midhunjac/RF-handover/Graphs/Data_collected/Data_collected/Supplementary/BodyPos_schematic.PNG

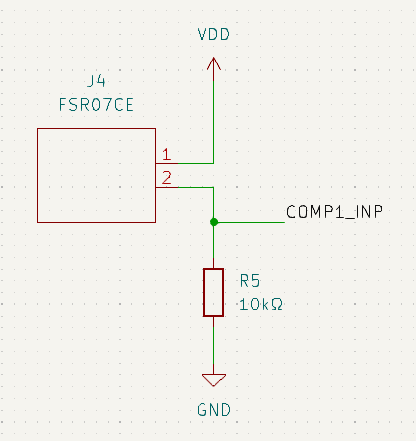
Graphs/Data_collected/Data_collected/Supplementary/BodyPos_schematic.PNG
