midhunjac/RF-handover/Graphs/Data_collected/Data_collected/Supplementary/Cadence_schematic.PNG

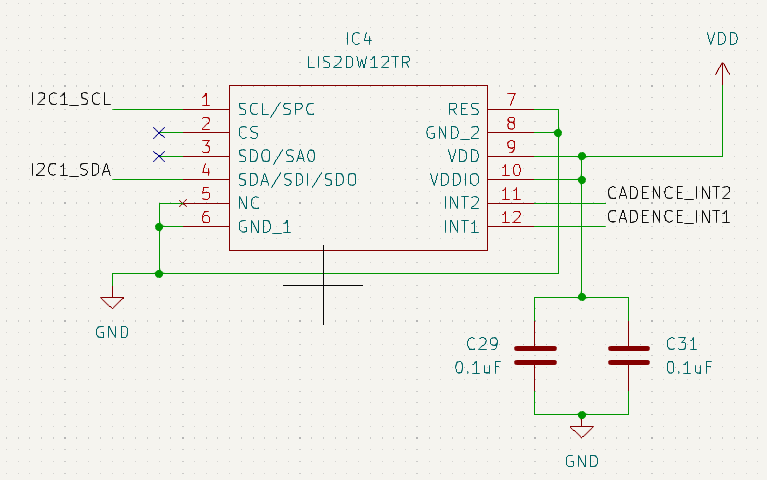
Graphs/Data_collected/Data_collected/Supplementary/Cadence_schematic.PNG
