midhunjac/RF-handover/Graphs/Data_collected/Data_collected/Supplementary/HandPos_schematic.PNG

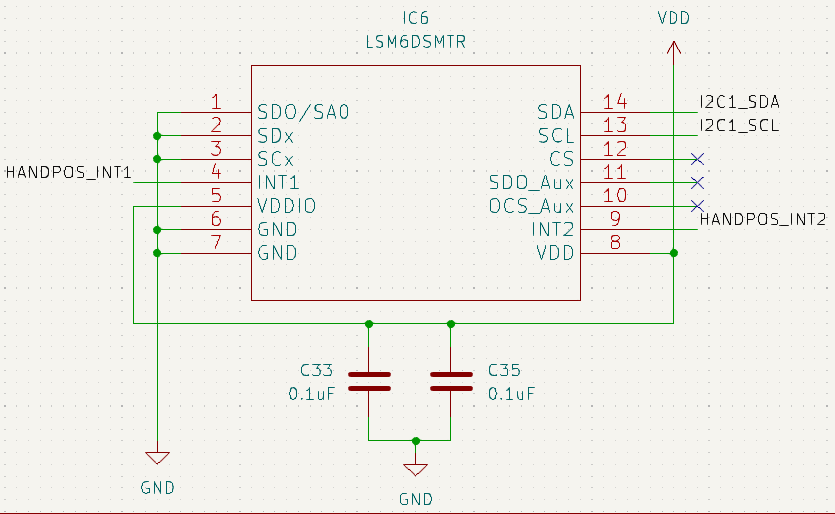
Graphs/Data_collected/Data_collected/Supplementary/HandPos_schematic.PNG
