midhunjac/RF-handover/Graphs/Data_collected/Data_collected/Supplementary/Temperature_schematic.PNG

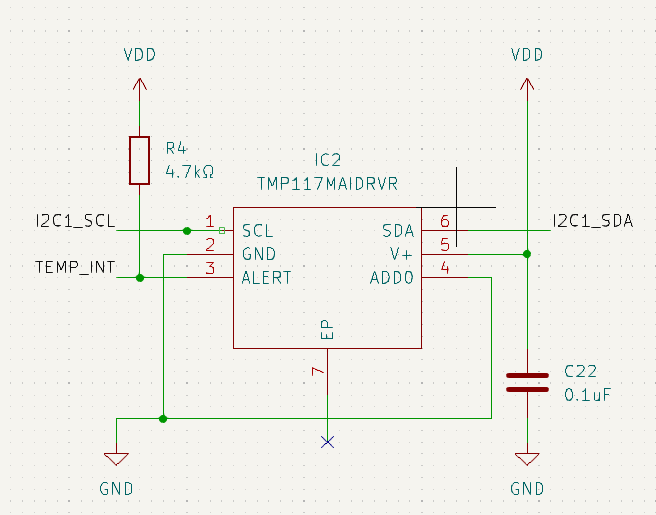
Graphs/Data_collected/Data_collected/Supplementary/Temperature_schematic.PNG
