midhunjac/RF-handover/Flexible Temperature Sensor/KiCAD/BOM.xlsx

Comment | Designator | Footprint | JLCPCB Part
MCU | IC5 | UFQFPN-48(7x7) | C3606695
10k resistor | R1 | 0603 | C1511834
Tactile switch | S1 | SMD, 2.8x4.6mm | C99271
Schottky Diode | D1 | SOD-523 | C283259
0.1uF Ceramic Capacitor | C3, C4, C5, C6, C7, C8, C9, C10, C12, C14, C18, C40 | 0603 | C14663
10pF Ceramic Capacitor | C1, C2 | 0603 | C85966
4.7k resistor | R2, R3, R4, R5, R6, R7 | 0603 | C723699
0.1nF Ceramic Capacitor | C16 | 0603 | C3885945
4.7uF Ceramic Capacitor | C21 | 0603 | C458917
10nH Inductor | L1 | 0603 | C86131
470uF Electrolytic Capacitor | C11 | SMD,D8xL10.2mm | C401707
2.5V voltage Detector | U1 | SOT-23-3 | C216610
N Channel MOSFET | Q2, Q3 | SOT-23(TO-236) | C142553
P Channel MOSFET | Q1 | SOT-23 | C168745
2.0V Voltage Detector | U2 | SOT-23 | C2461421
Temperature Sensor | IC1, IC2, IC3, IC4 | WDFN-6-EP(2x2) | C699536
560k Resistor | R8 | 0603 | C441907
