midhunjac/RF-handover/Flexible Temperature Sensor/KiCAD/BOM_components.xlsx

Sheet: JLCPCB
MFR Part | JLCPCB Part | Package | Designator | Description
STM32WB15CCU6 | C3606695 | UFQFPN-48(7x7) | IC5 | MCU
CRCW060310K0JNEBC | C1511834 | 0603 | R1 | 10k resistor
KMR231GLFS | C99271 | SMD, 2.8x4.6mm | S1 | Tactile switch
BAT54KFILM | C283259 | SOD-523 | D1 | Schottky Diode
CC0603KRX7R9BB104 | C14663 | 0603 | C3, C4, C5, C6, C7, C8, C9, C10, C12, C14, C18, C40 | 0.1uF Ceramic Capacitor
0603N100K500CT | C296045 | 0603 | C1, C2 | 10pF Ceramic Capacitor
RT0603DRE074K7L | C723699 | 0603 | R2, R3, R4, R5, R6, R7 | 4.7k resistor
GRM1885C1H101GA01J | C3885945 | 0603 | C16 | 0.1nF Ceramic Capacitor
0603X475M100CT | C458917 | 0603 | C21 | 4.7uF Ceramic Capacitor
LQW18AN10NG00D | C86131 | 0603 | L1 | 10nH Inductor
EEEFK1C471AP | C401707 | SMD,D8xL10.2mm | C11 | 470uF Electrolytic Capacitor
XC61CC2502MR-G | C216610 | SOT-23-3 | U1 | 2.5V voltage Detector
SI2342DS-T1-GE3 | C142553 | SOT-23(TO-236) | Q2, Q3 | N Channel MOSFET
NTR2101PT1G | C168745 | SOT-23 | Q1 | P Channel MOSFET
XC61CC2002MR-G | C2461421 | SOT-23 | U2 | 2.0V Voltage Detector
TMP117AIDRVR | C699536 | WDFN-6-EP(2x2) | IC1, IC2, IC3, IC4 | Temperature Sensor
ERJPA3J564V | C441907 | 0603 | R8 | 560k Resistor

Sheet: Digikey
Mfr No | Digikey No | Designator | Comment
M20-8760342 | 952-1922-ND | J3 | 2x6 Pin Header, 2.54mm
NX2016SA-32MHZ-EXS00A-CS06654 | 644-1373-1-ND | Y1 | Crystal 32MHz
NX2012SA-32.768KHZ-EXS00A-MU00389 | 644-1350-1-ND | Y2 | Crystal 32.768kHz
HZ0603C601R-10 | 240-2380-1-ND | FB1 | Ferrite Bead 600Ohm
74479777310A | 732-74479777310ACT-ND | L2 | 10uH Inductor
M20-8770242 | M20-8770242-ND | J2 | 1x2 Pin Header, 2.54mm
