midhunjac/RF-handover/Flexible Temperature Sensor/KiCAD/gdp_flexible.kicad_pcb

## KiCad design Flexible Temperature Sensor/KiCAD/gdp_flexible.kicad_pcb (2024-02-27)

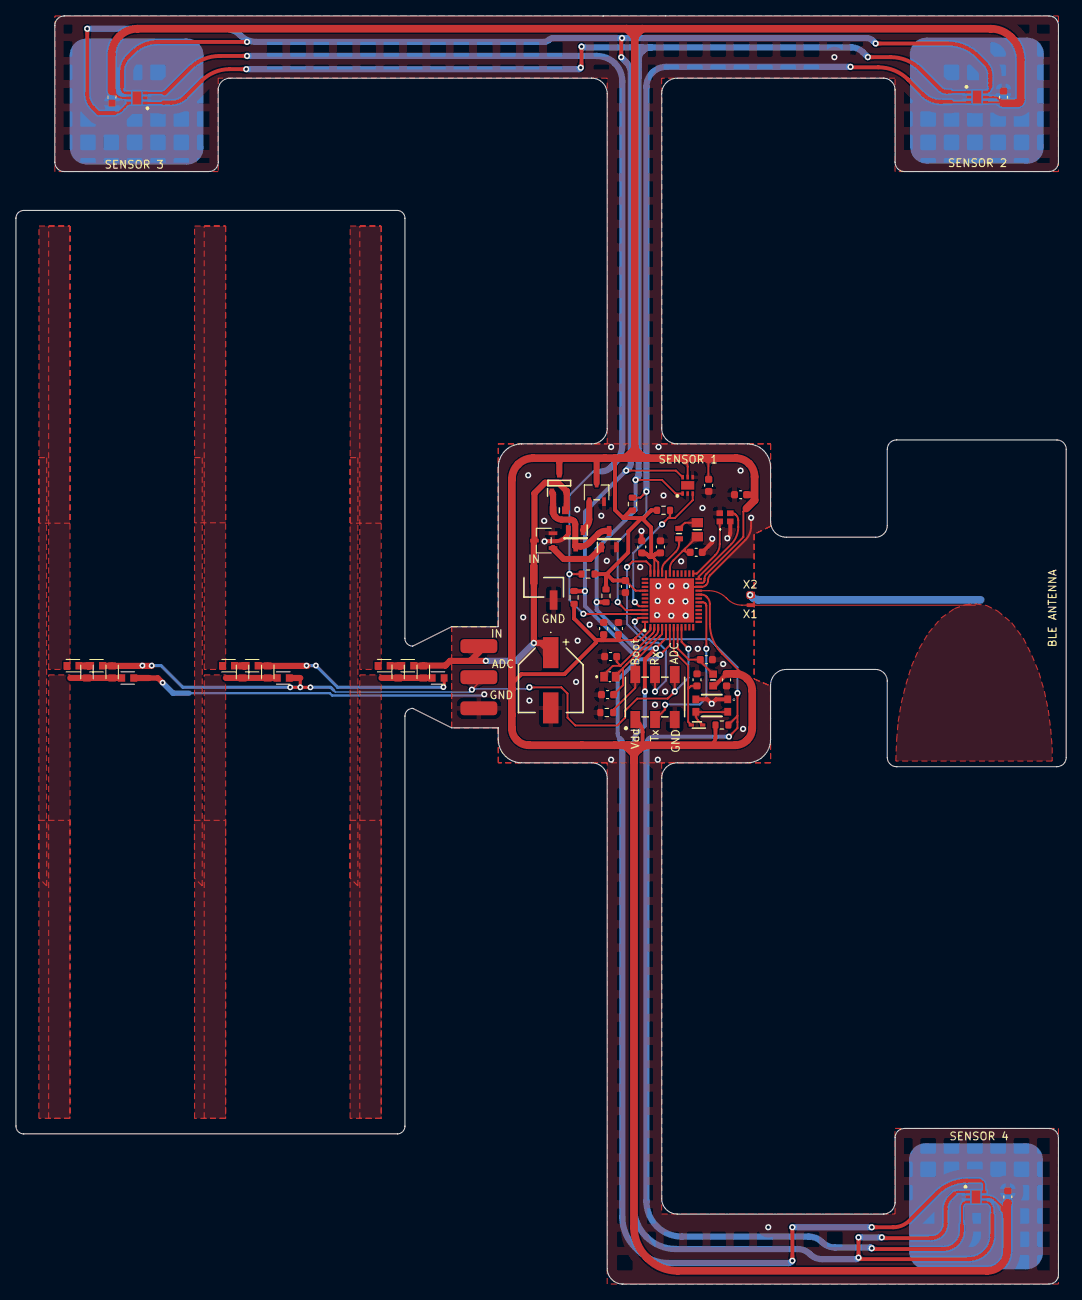
[picture p13: board gdp_flexible.kicad_pcb from above]

Board: 2 copper layers, 135.0 x 163.0 mm, 61 parts (0 on the bottom side), 27 nets.

Parts:
C1, C2: 10pF; C_0603_1608Metric
C3, C4, C5, C6, C7, C8, C9, C10, C12, C14, C18, C40: 0.1uF; C_0603_1608Metric
C11: EEE-FK1C471AP; EEHZT1E331UP
C16: 0.1nF; C_0603_1608Metric
C21: 4.7uF; C_0603_1608Metric
C50, C51, C52, C53, C54, C55, C56, C57, C58, C59, C60, C61: CAPC1608X85
D1: BAT54KFILM; SODFL1608X70N
FB1: HZ0603C601R-10; BEADC1608X95N
IC1, IC2, IC3, IC4: TMP117AIDRVR; SON65P200X200X80-7N
IC5: STM32WB15CCU6; QFN50P700X700X60-49N-D
J2: M20-8770242
J3: M20-8760342
L1: LQW18AN10NG00D; LQW18AS10NG0CD
L2: 74479777310A; INDC2112X140N
L3, L4, L5: INDC1608X95N
Q1: NTR2101PT1G; SOT96P237X111-3N
Q2, Q3: SI2342DS-T1-GE3; SOT95P237X102-3N
R1: 10kΩ; R_0603_1608Metric
R2, R3, R4, R5, R6, R7: 4.7kΩ; R_0603_1608Metric
R8: RESC1608X55N
S1: KMR231GLFS; KMR2_1
U1: XC61CC2502MR-G; XC61C_SOT-23_TOR
U2: XC61CC2002MR-G; XC61C_SOT-23_TOR
X1: Antenna_Flexible_RF
X2: Antenna_Flexible_GND
Y1: NX2016SA-32MHZ-EXS00A-CS06654; NX2016SA32MHZEXS00ACS06654
Y2: NX2012SA-32.768KHZ-EXS00A-MU00389; NX2012SA32768KHZEXS00AMU00530

Connections:
/NRST: C3.1, D1.2, IC5.7 (NRST)
/PH3-BOOT0: IC5.4 (PH3-BOOT0), J3.2, R1.2
/RCC_OSC32_IN: C1.1, IC5.2 (PC14-OSC32_IN), Y2.1
/RCC_OSC32_OUT: C2.1, IC5.3 (PC15-OSC32_OUT), Y2.2
/RCC_OSC_IN: IC5.25 (OSC_IN), Y1.1 (CRYSTAL_1)
/RCC_OSC_OUT: IC5.24 (OSC_OUT), Y1.3 (CRYSTAL_2)
/RF1: IC5.21 (RF1), X1.1 (RF)
/USART1_RX: IC5.36 (PA10), J3.4
/USART1_TX: IC5.18 (PA9), J3.3
/VDDA: C4.1, FB1.2, IC5.8 (VDDA)
/VFBSMPS: C21.1, IC5.31 (VFBSMPS), L2.2
/VLXSMPS: IC5.33 (VLXSMPS), L1.1
ADC: C58.1, C59.1, IC5.9 (PA0), J3.6, L4.1
GND: C1.2, C2.2, C3.2, C4.2, C5.2, C6.2, C7.2, C8.2, C9.2, C10.2, C11.2 (-), C12.2, C14.2, C16.2, C18.2, C21.2, C40.2, IC1.2 (GND_1), IC1.4 (ADD0), IC2.2 (GND_1), IC3.2 (GND_1), IC4.2 (GND_1), IC5.22 (VSSRF), IC5.32 (VSSSMPS), IC5.49 (EP), J2.2, J3.5, L5.1, Q2.2 (S), Q3.2 (S), R1.1, S1.1, S1.2, U1.2 (VSS), U2.2 (VSS), X2.1 (GND), Y1.2 (GND_1), Y1.4 (GND_2)
I2C_SCL: IC1.1 (SCL), IC2.1 (SCL), IC3.1 (SCL), IC4.1 (SCL), IC4.4 (ADD0), IC5.5 (PB8), R3.2
I2C_SDA: IC1.6 (SDA), IC2.6 (SDA), IC3.4 (ADD0), IC3.6 (SDA), IC4.6 (SDA), IC5.6 (PB9), R2.2
unnamed: C11.1 (+), C50.1, C51.1, J2.1, Q1.2 (S), R8.2, U1.3 (VIN)
unnamed: D1.1, S1.3, S1.4
unnamed: L1.2, L2.1
unnamed: Q1.1 (G), Q2.3 (D), Q3.3 (D), R8.1
unnamed: Q2.1 (G), U1.1 (VOUT)
unnamed: Q3.1 (G), U2.1 (VOUT)
TEMP_INT_1: IC1.3 (ALERT), IC5.44 (PB4), R4.2
TEMP_INT_2: IC2.3 (ALERT), IC5.45 (PB5), R6.2
TEMP_INT_3: IC3.3 (ALERT), IC5.46 (PB6), R5.2
TEMP_INT_4: IC4.3 (ALERT), IC5.47 (PB7), R7.2
VDD_OUTPUT: C5.1, C6.1, C7.1, C8.1, C9.1, C10.1, C12.1, C14.1, C16.1, C18.1, C40.1, FB1.1, IC1.5 (V+), IC2.4 (ADD0), IC2.5 (V+), IC3.5 (V+), IC4.5 (V+), IC5.1 (VBAT), IC5.20 (VDD_1), IC5.23 (VDDRF), IC5.34 (VDDSMPS), IC5.35 (VDD_2), IC5.40 (VDD_3), IC5.48 (VDD_4), J3.1, Q1.3 (D), R2.1, R3.1, R4.1, R5.1, R6.1, R7.1, U2.3 (VIN)
