midhunjac/RF-handover/Flexible Temperature Sensor/KiCAD/gdp_flexible_d3.kicad_pcb

## KiCad design Flexible Temperature Sensor/KiCAD/gdp_flexible_d3.kicad_pcb (2024-02-27)

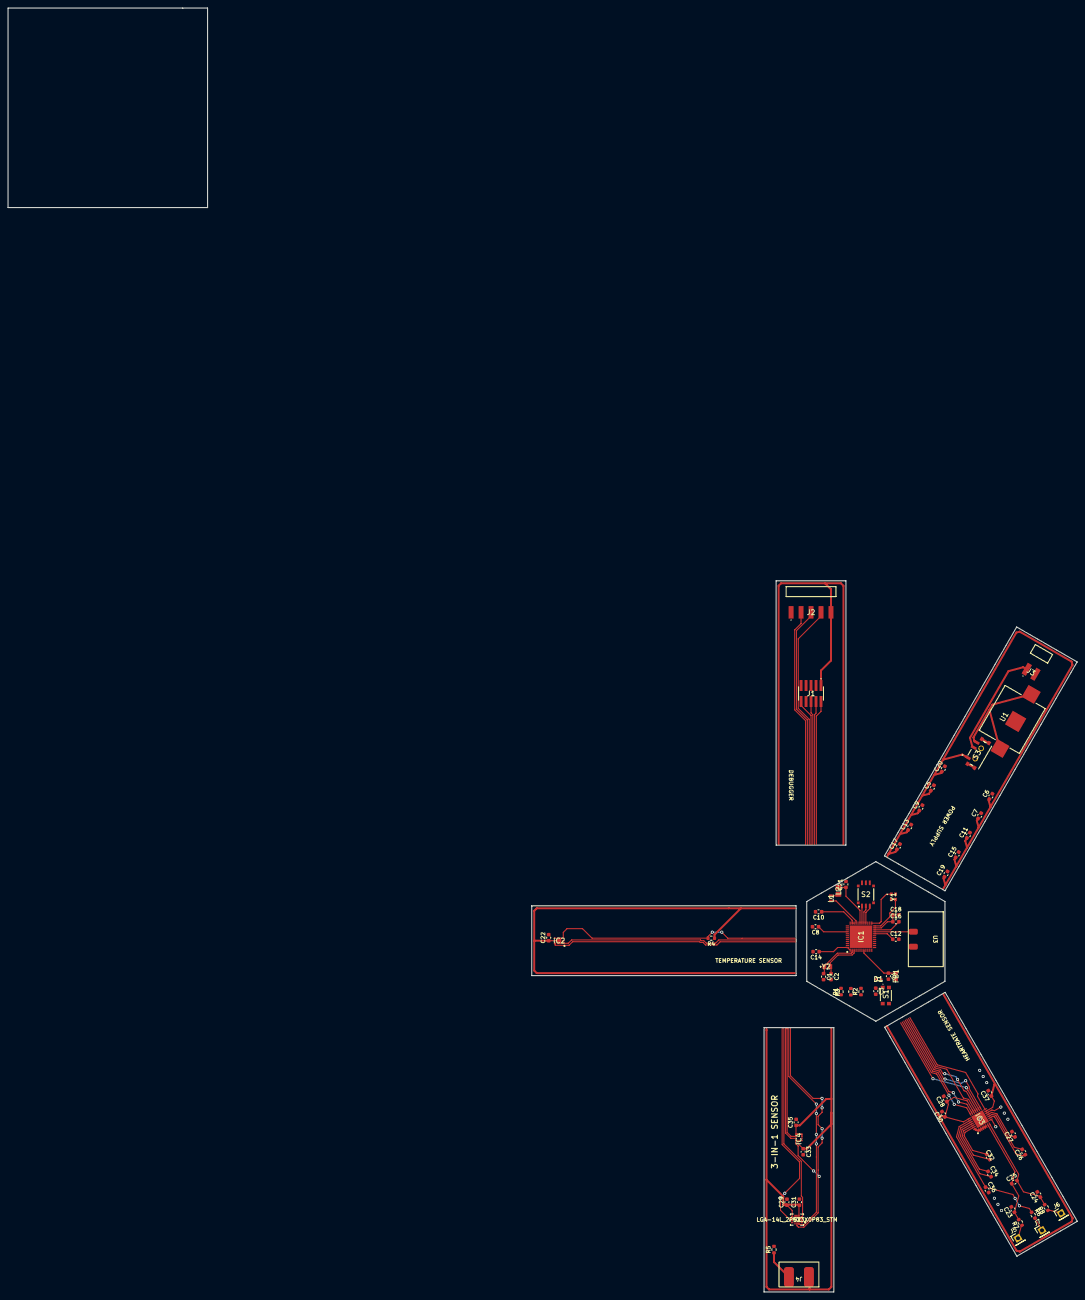
[picture p14: board gdp_flexible_d3.kicad_pcb from above]

Board: 2 copper layers, 272.3 x 326.9 mm, 68 parts (0 on the bottom side), 50 nets.

Parts:
C1, C2, C3, C4, C5, C6, C7, C8, C9, C10, C11, C12, C13, C14, C15, C16, C17, C18, C19, C20, C21, C22, C23, C24, C25, C26, C27, C28, C29, C30, C31, C32, C33, C34, C35, C36, C37: C; C_0603_1608Metric
D1: BAT54KFILM; SODFL1608X70N
FB1: HZ0603C601R-10; BEADC1608X95N
IC1: STM32WB15CCU6; QFN50P700X700X60-49N-D
IC2: TMP117MAIDRVR; SON65P200X200X80-7N
IC3: MAX30003CTI+; QFN50P500X500X80-29N
IC4: LIS2DW12TR; LGA-12
J1: FTS-105-01-F-DV-TR; FTS-105-YY-XX-DV-TR
J2: TSM-105-01-T-SH; TSM-105-YY-ZZZ-SH
J3: TSM-102-01-L-SH; TSM-102-YY-ZZZ-SH
J4: FSR07CE
J5, J6, J7: Conn_01x01; PinHeader_1x01_P2.54mm_Vertical
L1: LQW18AN10NG00D; LQW18AS10NG0CD
L2: 74479777310A; INDC2112X140N
R1, R2, R3, R4, R5, R6, R7, R8: R; R_0603_1608Metric
S1: KMR231GLFS; KMR2_1
S2: CVS-03TB; CVS03TB
S3: CUS-12TB; CUS-12B
U1: S8201-46R
U2: LGA-14L_2P5X3X0P83_STM; LSM6DSMTR
U3: Antenna_Flexible_BLE
Y1: NX2016SA-32MHZ-EXS00A-CS06654; NX2016SA32MHZEXS00ACS06654
Y2: NX2012SA-32.768KHZ-EXS00A-MU00389; NX2012SA32768KHZEXS00AMU00530

Connections:
/CADENCE_INT1: IC1.47 (PB7), IC4.11 (INT2)
/CADENCE_INT2: IC1.46 (PB6), IC4.12 (INT1)
/CAPN: C26.2, IC3.10 (CAPN)
/CAPP: C26.1, IC3.9 (CAPP)
/COMP1_INP: IC1.19 (PB2), J4.2, R5.1
/CPPL: C27.1, IC3.11 (CPLL)
/ECGN: C24.1, C25.2, IC3.7 (ECGN), R8.2
/ECG_P: C23.1, C25.1, IC3.6 (ECGP), R7.2
/HANDPOS_INT1: IC1.45 (PB5), U2.4 (INT1)
/HANDPOS_INT2: IC1.44 (PB4), U2.9 (INT2)
/HR_INT1: IC1.11 (PA2), IC3.21 (INTB)
/HR_INT2: IC1.12 (PA3), IC3.20 (INT2B)
/I2C1_SCL: IC1.5 (PB8), IC2.1 (SCL), IC4.1 (SCL/SPC), R3.2, U2.13 (SCL)
/I2C1_SDA: IC1.6 (PB9), IC2.6 (SDA), IC4.4 (SDA/SDI/SDO), R2.2, U2.14 (SDA)
/MODE_B1: IC1.30 (PE4), S2.A1 (COM_1)
/MODE_B2: IC1.29 (PB1), S2.A2 (COM_2)
/MODE_B3: IC1.28 (PB0), S2.A3 (COM_3)
/NRST: D1.1, J1.10, S1.1, S1.3
/OSC_IN: IC1.25 (OSC_IN), Y1.1 (CRYSTAL_1)
/OSC_OUT: IC1.24 (OSC_OUT), Y1.3 (CRYSTAL_2)
/PB11-NRST: C3.1, D1.2, IC1.7 (NRST)
/PC14-OSC32_IN: C1.1, IC1.2 (PC14-OSC32_IN), Y2.1
/PC15-OSC32_OUT: C2.1, IC1.3 (PC15-OSC32_OUT), Y2.2
/PH3-BOOT0: IC1.4 (PH3-BOOT0), J2.4, R1.2
/RCC_MCO: IC1.17 (PA8), IC3.14 (FCLK)
/RF1: IC1.21 (RF1), U3.1
/SPI1_MISO: IC1.15 (PA6), IC3.18 (SDO)
/SPI1_MOSI: IC1.14 (PA5), IC3.17 (SDI)
/SPI1_NSS: IC1.13 (PA4), IC3.15 (CSB)
/SPI1_SCK: IC1.10 (PA1), IC3.16 (SCLK)
/SYS_JTCK-SWCLK: IC1.41 (PA14), J1.4
/SYS_JTDO-SWO: IC1.43 (PB3), J1.6
/SYS_JTMS-SWDIO: IC1.39 (PA13), J1.2
/TEMP_INT: IC1.42 (PA15), IC2.3 (ALERT), R4.2
/USART1_RX: IC1.36 (PA10), J2.3
/USART1_TX: IC1.18 (PA9), J2.2
/VBG: C32.1, IC3.27 (VBG)
/VCM: C34.1, IC3.25 (VCM)
/VDAA: C4.1, FB1.2, IC1.8 (VDDA)
/VDD_BAT: S3.3, U1.1, U1.3
/VDD_PS: J3.1, S3.2
/VFBSMPS: C21.1, IC1.31 (VFBSMPS), L2.2
/VLXSMPS: IC1.33 (VLXSMPS), L1.1
/VREF: C36.1, IC3.23 (VREF), R6.1
GND: C1.2, C2.2, C3.2, C4.2, C5.2, C6.2, C7.2, C8.2, C9.2, C10.2, C11.2, C12.2, C13.2, C14.2, C15.2, C16.2, C17.2, C18.2, C19.2, C20.2, C21.2, C22.2, C23.2, C24.2, C27.2, C28.2, C29.2, C30.2, C31.2, C32.2, C33.2, C34.2, C35.2, C36.2, C37.2, IC1.22 (VSSRF), IC1.32 (VSSSMPS), IC1.49 (EP), IC2.2 (GND), IC2.4 (ADD0), IC3.1 (I.C._1), IC3.2 (I.C._2), IC3.3 (AGND_1), IC3.4 (I.C._3), IC3.5 (I.C._4), IC3.8 (AGND_2), IC3.12 (DGND), IC3.24 (I.C._5), IC3.26 (I.C._6), IC3.28 (AGND_3), IC3.29 (THERMAL_PAD), IC4.6 (GND_1), IC4.7 (RES), IC4.8 (GND_2), J1.3, J1.5, J2.1, J3.2, R1.1, R5.2, S1.2, S1.4, S2.MP1, S2.MP2, S2.MP3, S2.MP4, S3.4, S3.5, S3.6, S3.7, U1.2, U2.1 (SDO/SA0), U2.2 (SDx), U2.3 (SCx), U2.6 (GND), U2.7 (GND), U3.2, Y1.2 (GND_1), Y1.4 (GND_2)
unnamed: J5.1, R7.1
unnamed: J6.1, R8.1
unnamed: J7.1, R6.2
unnamed: L1.2, L2.1
VDD: C5.1, C6.1, C7.1, C8.1, C9.1, C10.1, C11.1, C12.1, C13.1, C14.1, C15.1, C16.1, C17.1, C18.1, C19.1, C20.1, C22.1, C28.1, C29.1, C30.1, C31.1, C33.1, C35.1, C37.1, FB1.1, IC1.1 (VBAT), IC1.20 (VDD_1), IC1.23 (VDDRF), IC1.34 (VDDSMPS), IC1.35 (VDD_2), IC1.40 (VDD_3), IC1.48 (VDD_4), IC2.5 (V+), IC3.13 (DVDD), IC3.19 (OVDD), IC3.22 (AVDD), IC4.2 (CS), IC4.9 (VDD), IC4.10 (VDDIO), J1.1, J2.5, J4.1, R2.1, R3.1, R4.1, S2.B1 (NO_1), S2.B2 (NO_2), S2.B3 (NO_3), S3.1, U2.5 (VDDIO), U2.8 (VDD)
