midhunjac/RF-handover/Flexible Temperature Sensor/Rectenna_final/PCB_rectenna_withL_Array v2.kicad_pcb

## KiCad design Flexible Temperature Sensor/Rectenna_final/PCB_rectenna_withL_Array v2.kicad_pcb (2024-02-27)

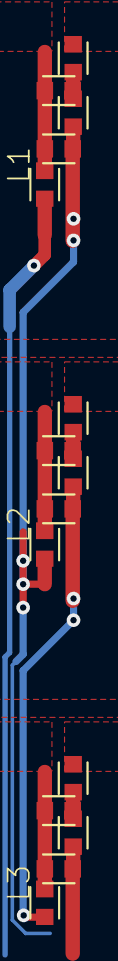
[picture p15: board PCB_rectenna_withL_Array v2.kicad_pcb from above]

Board: 2 copper layers, 15 parts (0 on the bottom side), 9 nets.

Parts:
C1, C2, C3, C4, C5, C6, C7, C8, C9, C10, C11, C12: CAPC1608X85
L1, L2, L3: INDC1608X95N

Connections:
ADC: C6.1, C7.1, L2.1
ANTIN: C4.1, C5.1, C7.2, L1.2
ANTIN2: C1.1, C2.1, C8.2, L2.2
ANTIN4: C9.1, C10.1, C12.2, L3.2
INPUT1: C3.1, C8.1, L3.1
INPUT2: C11.1, C12.1
unnamed: C1.2, C2.2, C3.2
unnamed: C9.2, C10.2, C11.2
unnamed: C4.2, C5.2, C6.2
