midhunjac/RF-handover/BLE_Beacon_Cadence/Core/Src/main.c

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
/* Includes ------------------------------------------------------------------*/
#include "main.h"

/* USER CODE BEGIN Includes */
#include <stdio.h>
#include "LIS2DW12.h"
#include "stm32_seq.h"
/* USER CODE END Includes */

/* USER CODE BEGIN PD */
#define MaxBuffer	6
/* USER CODE END PD */

I2C_HandleTypeDef hi2c1;

IPCC_HandleTypeDef hipcc;

RTC_HandleTypeDef hrtc;

UART_HandleTypeDef huart1;

/* USER CODE BEGIN PV */
float data[3];
uint8_t isReturnTop = 0;
uint8_t isReturnBottom = 0;
uint8_t count = 0;
uint8_t buffer[MaxBuffer] = {0,0,0,0,0,0};
uint8_t sumofBuffer = 0;
uint8_t duration = 0;
uint8_t rpm  = 0;

float z_data[25];
/* USER CODE END PV */

void SystemClock_Config(void);
void PeriphCommonClock_Config(void);
static void MX_GPIO_Init(void);
static void MX_I2C1_Init(void);
static void MX_IPCC_Init(void);
static void MX_RF_Init(void);
static void MX_RTC_Init(void);
static void MX_USART1_UART_Init(void);
/* USER CODE BEGIN PFP */
uint8_t runAlgo(void);

#ifdef __GNUC__
#define PUTCHAR_PROTOTYPE int __io_putchar(int ch)
#else
#define PUTCHAR_PROTOTYPE int fputc(int ch, FILE *f)
#endif

PUTCHAR_PROTOTYPE
{
  HAL_UART_Transmit(&huart1, (uint8_t *)&ch, 1, HAL_MAX_DELAY);
  return ch;
}

/* USER CODE END PFP */

/* USER CODE BEGIN 0 */
uint8_t runAlgo(void) {
	if(LIS2DW12_Get_FIFO_FTH(hi2c1) == 0x80) {
		LIS2DW12_Get_FIFO_Z(hi2c1, z_data);
		LIS2DW12_Reset_FIFO(hi2c1);

		count = 0;
		if(duration == MaxBuffer) {
			rpm = sumofBuffer * 5;
			if((rpm >= 5) && (rpm <= 35)) {
				rpm = 40;
			}
			duration = 0;
		}

		for(int i = 0; i < 25; i++) {
			if(z_data[i] >= 70.0) {
				isReturnTop = 0;
				isReturnBottom = 0;
			} else if((z_data[i] > 8.0) && (!isReturnTop)) {
				isReturnTop = 1;
			} else if((z_data[i] < 5.0) && (isReturnTop)) {
				isReturnBottom = 1;
			}

			if((isReturnTop) && (isReturnBottom)) {
				isReturnTop = 0;
				isReturnBottom = 0;
				count += 1;
			}
			printf("$%f %d %d %d;", z_data[i], count, sumofBuffer, rpm);
		}
		sumofBuffer = 0;
		buffer[duration] = count;
		for(int i = 0; i < MaxBuffer; i++) {
			sumofBuffer += buffer[i];
		}
		duration += 1;
		return rpm;

	}else {
		return 0;
	}
}

/* USER CODE END 0 */

/**
  * @brief  The application entry point.
  * @retval int
  */
int main(void)
{
  /* MCU Configuration--------------------------------------------------------*/

  /* Reset of all peripherals, Initializes the Flash interface and the Systick. */
  HAL_Init();
  /* Config code for STM32_WPAN (HSE Tuning must be done before system clock configuration) */
  MX_APPE_Config();

  /* Configure the system clock */
  SystemClock_Config();

/* Configure the peripherals common clocks */
  PeriphCommonClock_Config();

  /* IPCC initialisation */
   MX_IPCC_Init();

  /* Initialize all configured peripherals */
  MX_GPIO_Init();
  MX_I2C1_Init();
  MX_RF_Init();
  MX_RTC_Init();
  MX_USART1_UART_Init();
  /* Init code for STM32_WPAN */
  MX_APPE_Init();

  /* Infinite loop */
  /* USER CODE BEGIN WHILE */
  while (1)
  {
    /* USER CODE END WHILE */
    MX_APPE_Process();

    /* USER CODE BEGIN 3 */

  }
  /* USER CODE END 3 */
}

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
/* USER CODE BEGIN 4 */
void HAL_GPIO_EXTI_Callback(uint16_t GPIO_Pin) {
	if(GPIO_Pin == GPIO_PIN_6) {
		SystemClock_Config();
		HAL_ResumeTick();
		UTIL_SEQ_SetTask(1<<CFG_TASK_GET_CADENCE, CFG_SCH_PRIO_0);
	}
}
/* USER CODE END 4 */
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
