midhunjac/RF-handover/beacon_multitemp_adc/beacon_multitemp_adc.ioc

Mcu.UserName=STM32WB15CCUx
PA0.Signal=ADCx_IN5
PB4.GPIO_Label=Data_Ready_1
PB4.Signal=GPXTI4
PB5.GPIO_Label=Data_Ready_2
PB5.Signal=GPXTI5
PB6.GPIO_Label=Data_Ready_3
PB6.Signal=GPXTI6
PB7.GPIO_Label=Data_Ready_4
PB7.Signal=GPXTI7
PB8.Signal=I2C1_SCL
PB9.Signal=I2C1_SDA
PC14-OSC32_IN.Signal=RCC_OSC32_IN
PC15-OSC32_OUT.Signal=RCC_OSC32_OUT
