midhunjac/RF-handover/beacon_multitemp_adc/Core/Inc/main.h

#define Data_Ready_1_Pin GPIO_PIN_4
#define Data_Ready_1_GPIO_Port GPIOB
#define Data_Ready_1_EXTI_IRQn EXTI4_IRQn
#define Data_Ready_2_Pin GPIO_PIN_5
#define Data_Ready_2_GPIO_Port GPIOB
#define Data_Ready_2_EXTI_IRQn EXTI9_5_IRQn
#define Data_Ready_3_Pin GPIO_PIN_6
#define Data_Ready_3_GPIO_Port GPIOB
#define Data_Ready_3_EXTI_IRQn EXTI9_5_IRQn
#define Data_Ready_4_Pin GPIO_PIN_7
#define Data_Ready_4_GPIO_Port GPIOB
#define Data_Ready_4_EXTI_IRQn EXTI9_5_IRQn
#define Device_ID_1	TMP117_DeviceID1
#define Device_ID_2	TMP117_DeviceID2
#define Device_ID_3	TMP117_DeviceID3
#define Device_ID_4	TMP117_DeviceID4
