midhunjac/RF-handover/BLE_Beacon_multiTemperature/STM32_WPAN/App/ibeacon_service.c

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

/* Includes ------------------------------------------------------------------*/
#include "app_common.h"
#include "ble.h"
#include "ibeacon.h"
#include "ibeacon_service.h"

/* USER CODE BEGIN Includes */
#include "TMP117.h"
#include "main.h"
/* USER CODE END Includes */


typedef struct
{
    uint16_t AdvertisingInterval;/*!< Specifies the desired advertising interval. */
    uint8_t * UuID;              /*!< Specifies the 16-byte UUID to which the beacon belongs. */
    uint8_t * MajorID;           /*!< Specifies the 2-byte beacon identifying information. */
    uint8_t * MinorID;           /*!< Specifies the 2-byte beacon identifying information. */
    uint8_t CalibratedTxPower;   /*!< Specifies the power at 1m. */
} IBeacon_InitTypeDef;
#define ADVERTISING_INTERVAL_INCREMENT (16)
/* USER CODE BEGIN PV */
extern I2C_HandleTypeDef hi2c1;
extern RTC_HandleTypeDef hrtc;
extern uint8_t deviceToBeRead;

uint16_t temperature_val[4] = {0,0,0,0};
uint8_t tempMSB_1 = 0;
uint8_t tempLSB_1 = 0;
uint8_t tempMSB_2 = 0;
uint8_t tempLSB_2 = 0;
uint8_t tempMSB_3 = 0;
uint8_t tempLSB_3 = 0;
uint8_t tempMSB_4 = 0;
uint8_t tempLSB_4 = 0;

/* USER CODE END PV */

/* Functions Definition ------------------------------------------------------*/

static tBleStatus IBeacon_Init(IBeacon_InitTypeDef *IBeacon_Init)
{
  tBleStatus ret = BLE_STATUS_SUCCESS;
  uint16_t AdvertisingInterval = (IBeacon_Init->AdvertisingInterval * ADVERTISING_INTERVAL_INCREMENT / 10);

  /* Disable scan response. */
  hci_le_set_scan_response_data(0, NULL);

  /* Put the device in a non-connectable mode. */
  ret = aci_gap_set_discoverable(ADV_NONCONN_IND,                          /*< Advertise as non-connectable, undirected. */
                                 AdvertisingInterval, AdvertisingInterval, /*< Set the advertising interval as 700 ms (0.625 us increment). */
                                 GAP_PUBLIC_ADDR, NO_WHITE_LIST_USE,           /*< Use the public address, with no white list. */
                                 0, NULL,                                  /*< Do not use a local name. */
                                 0, NULL,                                  /*< Do not include the service UUID list. */
                                 0, 0);                                    /*< Do not set a slave connection interval. */

  if (ret != BLE_STATUS_SUCCESS)
  {
    return ret;
  }

  /* Remove the TX power level advertisement (this is done to decrease the packet size). */
  ret = aci_gap_delete_ad_type(AD_TYPE_TX_POWER_LEVEL);

  if (ret != BLE_STATUS_SUCCESS)
  {
    return ret;
  }

  uint8_t service_data[] =
  {
    26,                                                                      /*< Length. */
    AD_TYPE_MANUFACTURER_SPECIFIC_DATA,                                      /*< Manufacturer Specific Data data type value. */
    0x4C, 0x00, 0x02, 0x15,                                                  /*< 32-bit Manufacturer Data. */
    IBeacon_Init->UuID[0],                                                   /*< 16-byte Proximity UUID. */
    IBeacon_Init->UuID[1],
    IBeacon_Init->UuID[2],
    IBeacon_Init->UuID[3],
    IBeacon_Init->UuID[4],
    IBeacon_Init->UuID[5],
    IBeacon_Init->UuID[6],
    IBeacon_Init->UuID[7],
    IBeacon_Init->UuID[8],
    IBeacon_Init->UuID[9],
    IBeacon_Init->UuID[10],
    IBeacon_Init->UuID[11],
    IBeacon_Init->UuID[12],
    IBeacon_Init->UuID[13],
    IBeacon_Init->UuID[14],
    IBeacon_Init->UuID[15],
    IBeacon_Init->MajorID[0],                                                /*< 2-byte Major. */
    IBeacon_Init->MajorID[1],
    IBeacon_Init->MinorID[0],                                                /*< 2-byte Minor. */
    IBeacon_Init->MinorID[1],
    IBeacon_Init->CalibratedTxPower,                                         /*< Ranging data. */
  };

  uint8_t flags[] =
  {
    2,                                                                      /*< Length. */
    AD_TYPE_FLAGS,                                                          /*< Flags data type value. */
    (FLAG_BIT_LE_GENERAL_DISCOVERABLE_MODE | FLAG_BIT_BR_EDR_NOT_SUPPORTED) /*< BLE general discoverable, without BR/EDR support. */
  };

  /* Update the service data. */
  ret = aci_gap_update_adv_data(sizeof(service_data), service_data);

  if (ret != BLE_STATUS_SUCCESS)
  {
    return ret;
  }

  /* Update the adverstising flags. */
  ret = aci_gap_update_adv_data(sizeof(flags), flags);

  if (ret != BLE_STATUS_SUCCESS)
  {
    return ret;
  }
  return ret;
}

void IBeacon_Process(void)
{
  /* Default ibeacon */
  uint8_t UuID[]    = { UUID };
  uint8_t MajorID[] = { MAJOR_ID };
  uint8_t MinorID[] = { MINOR_ID };

  IBeacon_InitTypeDef IBeacon_InitStruct =
  {
    .AdvertisingInterval = ADVERTISING_INTERVAL_IN_MS,
    .UuID                = UuID,
    .MajorID             = MajorID,
    .MinorID             = MinorID,
    .CalibratedTxPower   = CALIBRATED_TX_POWER_AT_1_M
  };

#ifdef USE_OTA
  if(((*(uint8_t *)(OTA_BEACON_DATA_ADDRESS + OFFSET_PAYLOAD_LENGTH)) ==  27) &&
     ((*(uint8_t *)(OTA_BEACON_DATA_ADDRESS + OFFSET_PAYLOAD_DATA)) ==  26))
  {
    uint8_t i;
    uint32_t data_address = OTA_BEACON_DATA_ADDRESS + OFFSET_PAYLOAD_DATA + 6;

    for(i = 0; i < 16; i++)
      IBeacon_InitStruct.UuID[i] = *(uint8_t *)(data_address + i);
    data_address += 16;
    for(i = 0; i < 2; i++)
      IBeacon_InitStruct.MinorID[i] = *(uint8_t *)(data_address + i);
    data_address += 2;
    for(i = 0; i < 2; i++)
      IBeacon_InitStruct.MajorID[i] = *(uint8_t *)(data_address + i);
    data_address += 2;
    IBeacon_InitStruct.CalibratedTxPower = *(uint8_t *)(data_address);
  }
#endif

  IBeacon_Init(&IBeacon_InitStruct);
}
/* USER CODE BEGIN FD */
void initTemp(void) {
	  TMP117_set_Configuration(hi2c1,0x03, 0xA4, Device_ID_2);			// 16s Continous
	  TMP117_set_Configuration(hi2c1,0x03, 0x24, Device_ID_1);			// 8s continous
	  TMP117_set_Configuration(hi2c1,0x03, 0x24, Device_ID_3);			// 8s continous
	  TMP117_set_Configuration(hi2c1,0x03, 0x24, Device_ID_4);			// 8s continous


}

void updateTemp(void) {

	temperature_val[0] = TMP117_get_Temperature(hi2c1, Device_ID_1);
	temperature_val[1] = TMP117_get_Temperature(hi2c1, Device_ID_2);
	temperature_val[2] = TMP117_get_Temperature(hi2c1, Device_ID_3);
	temperature_val[3] = TMP117_get_Temperature(hi2c1, Device_ID_4);
	tempMSB_1 = temperature_val[0] >> 8;
	tempLSB_1 = temperature_val[0] & 0xFF;
	tempMSB_2 = temperature_val[1] >> 8;
	tempLSB_2 = temperature_val[1] & 0xFF;
	tempMSB_3 = temperature_val[2] >> 8;
	tempLSB_3 = temperature_val[2] & 0xFF;
	tempMSB_4 = temperature_val[3] >> 8;
	tempLSB_4 = temperature_val[3] & 0xFF;

	/*switch (deviceToBeRead) {
		case 1:
			temperature_val[0] = TMP117_get_Temperature(hi2c1, Device_ID_1);
			tempMSB_1 = temperature_val[0] >> 8;
			tempLSB_1 = temperature_val[0] & 0xFF;
			break;
		case 2:
			temperature_val[1] = TMP117_get_Temperature(hi2c1, Device_ID_2);
			tempMSB_2 = temperature_val[1] >> 8;
			tempLSB_2 = temperature_val[1] & 0xFF;
			break;
		case 3:
			temperature_val[2] = TMP117_get_Temperature(hi2c1, Device_ID_3);
			tempMSB_3 = temperature_val[2] >> 8;
			tempLSB_3 = temperature_val[2] & 0xFF;
			break;
		case 4:
			temperature_val[3] = TMP117_get_Temperature(hi2c1, Device_ID_4);
			tempMSB_4 = temperature_val[3] >> 8;
			tempLSB_4 = temperature_val[3] & 0xFF;
			break;
		default:
			break;
	}*/

	uint8_t service_data[] =
		{
		  27,                                                        /*< Length. */
		  AD_TYPE_MANUFACTURER_SPECIFIC_DATA,                        /*< 1-byte Manufacturer Specific Data data type value. */
		  0x4C, 0x00, 												 /*< 2-byte Manufacturer Data (I-Beacon). */
		  tempMSB_1, tempLSB_1,                            					 /*< Temperature Data 1 */
		  0x00, 0x00, 0x00, 0x0e, 0x8e, 0x22, 0x45, 0x41,
	      0x9d, 0x4c, 0x21, 0xed, 0xae, 0x82, 0xed, 0x19,			 /*< 16-byte Proximity UUID. */
		  tempMSB_2, tempLSB_2,					 	 	 					 /*< 2-byte Major */
		  tempMSB_3, tempLSB_3,					 		     			 /*< 2-byte Temperature Data */
		  tempMSB_4, tempLSB_4,						     					         /*< 1-byte Power */
		};

    aci_gap_update_adv_data(sizeof(service_data), service_data);
    deviceToBeRead = 0;

	// Enter STOP MODE //
	HAL_SuspendTick();
	HAL_PWR_EnterSTOPMode(PWR_LOWPOWERREGULATOR_ON, PWR_STOPENTRY_WFI);
}
/* USER CODE END FD */
