midhunjac/RF-handover/RF-Wireless-Sensors-main/STM32Cube_FW_WB_V1.17.0/Projects/NUCLEO-WB15CC/Applications/BLE/BLE_p2pServer/STM32_WPAN/App/app_ble.c

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

/* Includes ------------------------------------------------------------------*/
#include "main.h"

#include "app_common.h"

#include "dbg_trace.h"
#include "ble.h"
#include "tl.h"
#include "app_ble.h"

#include "stm32_seq.h"
#include "shci.h"
#include "stm32_lpm.h"
#include "otp.h"

#include "p2p_server_app.h"


/**
 * security parameters structure
 */
typedef struct _tSecurityParams
{
  /**
   * IO capability of the device
   */
  uint8_t ioCapability;

  /**
   * Authentication requirement of the device
   * Man In the Middle protection required?
   */
  uint8_t mitm_mode;

  /**
   * bonding mode of the device
   */
  uint8_t bonding_mode;

  /**
   * this variable indicates whether to use a fixed pin
   * during the pairing process or a passkey has to be
   * requested to the application during the pairing process
   * 0 implies use fixed pin and 1 implies request for passkey
   */
  uint8_t Use_Fixed_Pin;

  /**
   * minimum encryption key size requirement
   */
  uint8_t encryptionKeySizeMin;

  /**
   * maximum encryption key size requirement
   */
  uint8_t encryptionKeySizeMax;

  /**
   * fixed pin to be used in the pairing process if
   * Use_Fixed_Pin is set to 1
   */
  uint32_t Fixed_Pin;

  /**
   * this flag indicates whether the host has to initiate
   * the security, wait for pairing or does not have any security
   * requirements.
   * 0x00 : no security required
   * 0x01 : host should initiate security by sending the slave security
   *        request command
   * 0x02 : host need not send the clave security request but it
   * has to wait for paiirng to complete before doing any other
   * processing
   */
  uint8_t initiateSecurity;
  /* USER CODE BEGIN tSecurityParams*/

  /* USER CODE END tSecurityParams */
}tSecurityParams;

/**
 * global context
 * contains the variables common to all
 * services
 */
typedef struct _tBLEProfileGlobalContext
{
  /**
   * security requirements of the host
   */
  tSecurityParams bleSecurityParam;

  /**
   * gap service handle
   */
  uint16_t gapServiceHandle;

  /**
   * device name characteristic handle
   */
  uint16_t devNameCharHandle;

  /**
   * appearance characteristic handle
   */
  uint16_t appearanceCharHandle;

  /**
   * connection handle of the current active connection
   * When not in connection, the handle is set to 0xFFFF
   */
  uint16_t connectionHandle;

  /**
   * length of the UUID list to be used while advertising
   */
  uint8_t advtServUUIDlen;

  /**
   * the UUID list to be used while advertising
   */
  uint8_t advtServUUID[100];
  /* USER CODE BEGIN BleGlobalContext_t*/

  /* USER CODE END BleGlobalContext_t */
}BleGlobalContext_t;

typedef struct
{
  BleGlobalContext_t BleApplicationContext_legacy;
  APP_BLE_ConnStatus_t Device_Connection_Status;

  /**
   * ID of the Advertising Timeout
   */
  uint8_t Advertising_mgr_timer_Id;

  uint8_t SwitchOffGPIO_timer_Id;
  /* USER CODE BEGIN PTD_1*/

  /* USER CODE END PTD_1 */
}BleApplicationContext_t;

#define APPBLE_GAP_DEVICE_NAME_LENGTH 7
#define FAST_ADV_TIMEOUT               (30*1000*1000/CFG_TS_TICK_VAL) /**< 30s */
#define INITIAL_ADV_TIMEOUT            (60*1000*1000/CFG_TS_TICK_VAL) /**< 60s */

#define BD_ADDR_SIZE_LOCAL    6

/* USER CODE BEGIN PD */
#define LED_ON_TIMEOUT                 (0.005*1000*1000/CFG_TS_TICK_VAL) /**< 5ms */
/* USER CODE END PD */

PLACE_IN_SECTION("MB_MEM1") ALIGN(4) static TL_CmdPacket_t BleCmdBuffer;

static const uint8_t a_MBdAddr[BD_ADDR_SIZE_LOCAL] =
{
  (uint8_t)((CFG_ADV_BD_ADDRESS & 0x0000000000FF)),
  (uint8_t)((CFG_ADV_BD_ADDRESS & 0x00000000FF00) >> 8),
  (uint8_t)((CFG_ADV_BD_ADDRESS & 0x000000FF0000) >> 16),
  (uint8_t)((CFG_ADV_BD_ADDRESS & 0x0000FF000000) >> 24),
  (uint8_t)((CFG_ADV_BD_ADDRESS & 0x00FF00000000) >> 32),
  (uint8_t)((CFG_ADV_BD_ADDRESS & 0xFF0000000000) >> 40)
};

static uint8_t a_BdAddrUdn[BD_ADDR_SIZE_LOCAL];

/**
 *   Identity root key used to derive LTK and CSRK
 */
static const uint8_t a_BLE_CfgIrValue[16] = CFG_BLE_IRK;

/**
 * Encryption root key used to derive LTK and CSRK
 */
static const uint8_t a_BLE_CfgErValue[16] = CFG_BLE_ERK;

/**
 * These are the two tags used to manage a power failure during OTA
 * The MagicKeywordAdress shall be mapped @0x140 from start of the binary image
 * The MagicKeywordvalue is checked in the ble_ota application
 */
PLACE_IN_SECTION("TAG_OTA_END") const uint32_t MagicKeywordValue = 0x94448A29 ;
PLACE_IN_SECTION("TAG_OTA_START") const uint32_t MagicKeywordAddress = (uint32_t)&MagicKeywordValue;

static BleApplicationContext_t BleApplicationContext;
static uint16_t AdvIntervalMin, AdvIntervalMax;

P2PS_APP_ConnHandle_Not_evt_t HandleNotification;

#if (L2CAP_REQUEST_NEW_CONN_PARAM != 0)
#define SIZE_TAB_CONN_INT            2
float a_ConnInterval[SIZE_TAB_CONN_INT] = {50, 1000}; /* ms */
uint8_t index_con_int, mutex;
#endif /* L2CAP_REQUEST_NEW_CONN_PARAM != 0 */

/**
 * Advertising Data
 */
#if (P2P_SERVER1 != 0)
static const char a_LocalName[] = {AD_TYPE_COMPLETE_LOCAL_NAME ,'P','2','P','S','R','V','1'};
uint8_t a_ManufData[14] = {sizeof(a_ManufData)-1,
                           AD_TYPE_MANUFACTURER_SPECIFIC_DATA,
                           0x01,                               /*SKD version */
                           CFG_DEV_ID_P2P_SERVER1,             /* STM32WB - P2P Server 1*/
                           0x00,                               /* GROUP A Feature */
                           0x00,                               /* GROUP A Feature */
                           0x00,                               /* GROUP B Feature */
                           0x00,                               /* GROUP B Feature */
                           0x00,                               /* BLE MAC start -MSB */
                           0x00,
                           0x00,
                           0x00,
                           0x00,
                           0x00,                               /* BLE MAC stop */
                          };
#endif /* P2P_SERVER1 != 0 */
/**
 * Advertising Data
 */
#if (P2P_SERVER2 != 0)
static const char a_LocalName[] = {AD_TYPE_COMPLETE_LOCAL_NAME, 'P', '2', 'P', 'S', 'R', 'V', '2'};
uint8_t a_ManufData[14] = {sizeof(a_ManufData)-1,
                           AD_TYPE_MANUFACTURER_SPECIFIC_DATA,
                           0x01,                               /*SKD version */
                           CFG_DEV_ID_P2P_SERVER2,             /* STM32WB - P2P Server 2*/
                           0x00,                               /* GROUP A Feature */
                           0x00,                               /* GROUP A Feature */
                           0x00,                               /* GROUP B Feature */
                           0x00,                               /* GROUP B Feature */
                           0x00,                               /* BLE MAC start -MSB */
                           0x00,
                           0x00,
                           0x00,
                           0x00,
                           0x00,                               /* BLE MAC stop */
                          };

#endif /* P2P_SERVER2 != 0 */

#if (P2P_SERVER3 != 0)
static const char a_LocalName[] = {AD_TYPE_COMPLETE_LOCAL_NAME, 'P', '2', 'P', 'S', 'R', 'V', '3'};
uint8_t a_ManufData[14] = {sizeof(a_ManufData)-1,
                           AD_TYPE_MANUFACTURER_SPECIFIC_DATA,
                           0x01,                               /*SKD version */
                           CFG_DEV_ID_P2P_SERVER3,             /* STM32WB - P2P Server 3*/
                           0x00,                               /* GROUP A Feature */
                           0x00,                               /* GROUP A Feature */
                           0x00,                               /* GROUP B Feature */
                           0x00,                               /* GROUP B Feature */
                           0x00,                               /* BLE MAC start -MSB */
                           0x00,
                           0x00,
                           0x00,
                           0x00,
                           0x00,                               /* BLE MAC stop */
                          };
#endif /* P2P_SERVER3 != 0 */

#if (P2P_SERVER4 != 0)
static const char a_LocalName[] = {AD_TYPE_COMPLETE_LOCAL_NAME, 'P', '2', 'P', 'S', 'R', 'V', '4'};
uint8_t a_ManufData[14] = {sizeof(a_ManufData)-1,
                           AD_TYPE_MANUFACTURER_SPECIFIC_DATA,
                           0x01,                               /*SKD version */
                           CFG_DEV_ID_P2P_SERVER4,             /* STM32WB - P2P Server 4*/
                           0x00,                               /* GROUP A Feature */
                           0x00,                               /* GROUP A Feature */
                           0x00,                               /* GROUP B Feature */
                           0x00,                               /* GROUP B Feature */
                           0x00,                               /* BLE MAC start -MSB */
                           0x00,
                           0x00,
                           0x00,
                           0x00,
                           0x00,                               /* BLE MAC stop */
                          };
#endif /* P2P_SERVER4 != 0 */

#if (P2P_SERVER5 != 0)
static const char a_LocalName[] = {AD_TYPE_COMPLETE_LOCAL_NAME, 'P', '2', 'P', 'S', 'R', 'V', '5'};
uint8_t a_ManufData[14] = {sizeof(a_ManufData)-1,
                           AD_TYPE_MANUFACTURER_SPECIFIC_DATA,
                           0x01,                               /*SKD version */
                           CFG_DEV_ID_P2P_SERVER5,             /* STM32WB - P2P Server 5*/
                           0x00,                               /* GROUP A Feature */
                           0x00,                               /* GROUP A Feature */
                           0x00,                               /* GROUP B Feature */
                           0x00,                               /* GROUP B Feature */
                           0x00,                               /* BLE MAC start -MSB */
                           0x00,
                           0x00,
                           0x00,
                           0x00,
                           0x00,                               /* BLE MAC stop */
                          };
#endif /* P2P_SERVER5 != 0 */

#if (P2P_SERVER6 != 0)
static const char a_LocalName[] = {AD_TYPE_COMPLETE_LOCAL_NAME, 'P', '2', 'P', 'S', 'R', 'V', '6'};
uint8_t a_ManufData[14] = {sizeof(a_ManufData)-1,
                           AD_TYPE_MANUFACTURER_SPECIFIC_DATA,
                           0x01,                               /*SKD version */
                           CFG_DEV_ID_P2P_SERVER6,             /* STM32WB - P2P Server 6*/
                           0x00,                               /* GROUP A Feature */
                           0x00,                               /* GROUP A Feature */
                           0x00,                               /* GROUP B Feature */
                           0x00,                               /* GROUP B Feature */
                           0x00,                               /* BLE MAC start -MSB */
                           0x00,
                           0x00,
                           0x00,
                           0x00,
                           0x00,                               /* BLE MAC stop */
                          };
#endif /* P2P_SERVER6 != 0 */

static void BLE_UserEvtRx(void *p_Payload);
static void BLE_StatusNot(HCI_TL_CmdStatus_t Status);
static void Ble_Tl_Init(void);
static void Ble_Hci_Gap_Gatt_Init(void);
static const uint8_t* BleGetBdAddress(void);
static void Adv_Request(APP_BLE_ConnStatus_t NewStatus);
static void Adv_Cancel(void);
static void Adv_Cancel_Req(void);
static void Switch_OFF_GPIO(void);
#if (L2CAP_REQUEST_NEW_CONN_PARAM != 0)
static void BLE_SVC_L2CAP_Conn_Update(uint16_t ConnectionHandle);
static void Connection_Interval_Update_Req(void);
#endif /* L2CAP_REQUEST_NEW_CONN_PARAM != 0 */

/* External variables --------------------------------------------------------*/
extern RNG_HandleTypeDef hrng;

/* Functions Definition ------------------------------------------------------*/
void APP_BLE_Init(void)
{
  SHCI_CmdStatus_t status;
#if (RADIO_ACTIVITY_EVENT != 0)
  tBleStatus ret = BLE_STATUS_INVALID_PARAMS;
#endif /* RADIO_ACTIVITY_EVENT != 0 */
  SHCI_C2_Ble_Init_Cmd_Packet_t ble_init_cmd_packet =
  {
    {{0,0,0}},                          /**< Header unused */
    {0,                                 /** pBleBufferAddress not used */
     0,                                 /** BleBufferSize not used */
     CFG_BLE_NUM_GATT_ATTRIBUTES,
     CFG_BLE_NUM_GATT_SERVICES,
     CFG_BLE_ATT_VALUE_ARRAY_SIZE,
     CFG_BLE_NUM_LINK,
     CFG_BLE_DATA_LENGTH_EXTENSION,
     CFG_BLE_PREPARE_WRITE_LIST_SIZE,
     CFG_BLE_MBLOCK_COUNT,
     CFG_BLE_MAX_ATT_MTU,
     CFG_BLE_SLAVE_SCA,
     CFG_BLE_MASTER_SCA,
     CFG_BLE_LS_SOURCE,
     CFG_BLE_MAX_CONN_EVENT_LENGTH,
     CFG_BLE_HSE_STARTUP_TIME,
     CFG_BLE_VITERBI_MODE,
     CFG_BLE_OPTIONS,
     0,
     CFG_BLE_MAX_COC_INITIATOR_NBR,
     CFG_BLE_MIN_TX_POWER,
     CFG_BLE_MAX_TX_POWER,
     CFG_BLE_RX_MODEL_CONFIG,
     CFG_BLE_MAX_ADV_SET_NBR,
     CFG_BLE_MAX_ADV_DATA_LEN,
     CFG_BLE_TX_PATH_COMPENS,
     CFG_BLE_RX_PATH_COMPENS,
     CFG_BLE_CORE_VERSION,
     CFG_BLE_OPTIONS_EXT
    }
  };

  /**
   * Initialize Ble Transport Layer
   */
  Ble_Tl_Init();

#if (CFG_LPM_STANDBY_SUPPORTED == 0)
  UTIL_LPM_SetOffMode(1U << CFG_LPM_APP_BLE, UTIL_LPM_DISABLE);
#endif /* CFG_LPM_STANDBY_SUPPORTED == 0 */

  /**
   * Register the hci transport layer to handle BLE User Asynchronous Events
   */
  UTIL_SEQ_RegTask(1<<CFG_TASK_HCI_ASYNCH_EVT_ID, UTIL_SEQ_RFU, hci_user_evt_proc);

  /**
   * Starts the BLE Stack on CPU2
   */
  status = SHCI_C2_BLE_Init(&ble_init_cmd_packet);
  if (status != SHCI_Success)
  {
    APP_DBG_MSG("  Fail   : SHCI_C2_BLE_Init command, result: 0x%02x\n\r", status);
    /* if you are here, maybe CPU2 doesn't contain STM32WB_Copro_Wireless_Binaries, see Release_Notes.html */
    Error_Handler();
  }
  else
  {
    APP_DBG_MSG("  Success: SHCI_C2_BLE_Init command\n\r");
  }

  /**
   * Initialization of HCI & GATT & GAP layer
   */
  Ble_Hci_Gap_Gatt_Init();

  /**
   * Initialization of the BLE Services
   */
  SVCCTL_Init();

  /**
   * Initialization of the BLE App Context
   */
  BleApplicationContext.Device_Connection_Status = APP_BLE_IDLE;
  BleApplicationContext.BleApplicationContext_legacy.connectionHandle = 0xFFFF;

  /**
   * From here, all initialization are BLE application specific
   */
  UTIL_SEQ_RegTask(1<<CFG_TASK_ADV_CANCEL_ID, UTIL_SEQ_RFU, Adv_Cancel);
#if (L2CAP_REQUEST_NEW_CONN_PARAM != 0)
  UTIL_SEQ_RegTask(1<<CFG_TASK_CONN_UPDATE_REG_ID, UTIL_SEQ_RFU, Connection_Interval_Update_Req);
#endif /* L2CAP_REQUEST_NEW_CONN_PARAM != 0 */

  /**
   * Initialization of ADV - Ad Manufacturer Element - Support OTA Bit Mask
   */
#if (BLE_CFG_OTA_REBOOT_CHAR != 0)
  a_ManufData[sizeof(a_ManufData)-8] = CFG_FEATURE_OTA_REBOOT;
#endif /* BLE_CFG_OTA_REBOOT_CHAR != 0 */

#if (RADIO_ACTIVITY_EVENT != 0)
  ret = aci_hal_set_radio_activity_mask(0x0006);
  if (ret != BLE_STATUS_SUCCESS)
  {
    APP_DBG_MSG("  Fail   : aci_hal_set_radio_activity_mask command, result: 0x%x \n\r", ret);
  }
  else
  {
    APP_DBG_MSG("  Success: aci_hal_set_radio_activity_mask command\n\r");
  }
#endif /* RADIO_ACTIVITY_EVENT != 0 */

#if (L2CAP_REQUEST_NEW_CONN_PARAM != 0)
  index_con_int = 0;
  mutex = 1;
#endif /* L2CAP_REQUEST_NEW_CONN_PARAM != 0 */

  /**
   * Initialize P2P Server Application
   */
  P2PS_APP_Init();

  /**
   * Create timer to handle the Advertising Stop
   */
  HW_TS_Create(CFG_TIM_PROC_ID_ISR, &(BleApplicationContext.Advertising_mgr_timer_Id), hw_ts_SingleShot, Adv_Cancel_Req);
  /**
   * Create timer to handle the Led Switch OFF
   */
  HW_TS_Create(CFG_TIM_PROC_ID_ISR, &(BleApplicationContext.SwitchOffGPIO_timer_Id), hw_ts_SingleShot, Switch_OFF_GPIO);

  /**
   * Make device discoverable
   */
  BleApplicationContext.BleApplicationContext_legacy.advtServUUID[0] = NULL;
  BleApplicationContext.BleApplicationContext_legacy.advtServUUIDlen = 0;

  /* Initialize intervals for reconnexion without intervals update */
  AdvIntervalMin = CFG_FAST_CONN_ADV_INTERVAL_MIN;
  AdvIntervalMax = CFG_FAST_CONN_ADV_INTERVAL_MAX;

  /**
   * Start to Advertise to be connected by P2P Client
   */
  Adv_Request(APP_BLE_FAST_ADV);

  return;
}

SVCCTL_UserEvtFlowStatus_t SVCCTL_App_Notification(void *p_Pckt)
{
	printf("start notification\n\r");
  hci_event_pckt    *p_event_pckt;
  evt_le_meta_event *p_meta_evt;
  evt_blecore_aci   *p_blecore_evt;
  uint8_t           Tx_phy, Rx_phy;
  tBleStatus        ret = BLE_STATUS_INVALID_PARAMS;
  hci_le_connection_complete_event_rp0        *p_connection_complete_event;
  hci_disconnection_complete_event_rp0        *p_disconnection_complete_event;
  hci_le_phy_update_complete_event_rp0        *p_evt_le_phy_update_complete;
#if (CFG_DEBUG_APP_TRACE != 0)
  hci_le_connection_update_complete_event_rp0 *p_connection_update_complete_event;
#endif /* CFG_DEBUG_APP_TRACE != 0 */

  p_event_pckt = (hci_event_pckt*) ((hci_uart_pckt *) p_Pckt)->data;

  switch (p_event_pckt->evt)
  {
    case HCI_DISCONNECTION_COMPLETE_EVT_CODE:
    {
      p_disconnection_complete_event = (hci_disconnection_complete_event_rp0 *) p_event_pckt->data;

      if (p_disconnection_complete_event->Connection_Handle == BleApplicationContext.BleApplicationContext_legacy.connectionHandle)
      {
        BleApplicationContext.BleApplicationContext_legacy.connectionHandle = 0;
        BleApplicationContext.Device_Connection_Status = APP_BLE_IDLE;
        APP_DBG_MSG(">>== HCI_DISCONNECTION_COMPLETE_EVT_CODE\n");
        APP_DBG_MSG("     - Connection Handle:   0x%x\n     - Reason:    0x%x\n\r",
                    p_disconnection_complete_event->Connection_Handle,
                    p_disconnection_complete_event->Reason);

      }

      /* restart advertising */
      Adv_Request(APP_BLE_FAST_ADV);

      /**
       * SPECIFIC to P2P Server APP
       */
      HandleNotification.P2P_Evt_Opcode = PEER_DISCON_HANDLE_EVT;
      HandleNotification.ConnectionHandle = BleApplicationContext.BleApplicationContext_legacy.connectionHandle;
      P2PS_APP_Notification(&HandleNotification);
      break; /* HCI_DISCONNECTION_COMPLETE_EVT_CODE */
    }

    case HCI_LE_META_EVT_CODE:
    {
      p_meta_evt = (evt_le_meta_event*) p_event_pckt->data;
      switch (p_meta_evt->subevent)
      {
        case HCI_LE_CONNECTION_UPDATE_COMPLETE_SUBEVT_CODE:
#if (CFG_DEBUG_APP_TRACE != 0)
          p_connection_update_complete_event = (hci_le_connection_update_complete_event_rp0 *) p_meta_evt->data;
          APP_DBG_MSG(">>== HCI_LE_CONNECTION_UPDATE_COMPLETE_SUBEVT_CODE\n");
          APP_DBG_MSG("     - Connection Interval:   %.2f ms\n     - Connection latency:    %d\n     - Supervision Timeout: %d ms\n\r",
                       p_connection_update_complete_event->Conn_Interval*1.25,
                       p_connection_update_complete_event->Conn_Latency,
                       p_connection_update_complete_event->Supervision_Timeout*10);
#endif /* CFG_DEBUG_APP_TRACE != 0 */

          break;

        case HCI_LE_PHY_UPDATE_COMPLETE_SUBEVT_CODE:
          p_evt_le_phy_update_complete = (hci_le_phy_update_complete_event_rp0*)p_meta_evt->data;
          APP_DBG_MSG("==>> HCI_LE_PHY_UPDATE_COMPLETE_SUBEVT_CODE - ");
          if (p_evt_le_phy_update_complete->Status == 0)
          {
            APP_DBG_MSG("status ok \n");
          }
          else
          {
            APP_DBG_MSG("status nok \n");
          }

          ret = hci_le_read_phy(BleApplicationContext.BleApplicationContext_legacy.connectionHandle, &Tx_phy, &Rx_phy);
          if (ret != BLE_STATUS_SUCCESS)
          {
            APP_DBG_MSG("==>> hci_le_read_phy : fail\n\r");
          }
          else
          {
            APP_DBG_MSG("==>> hci_le_read_phy - Success \n");

            if ((Tx_phy == TX_2M) && (Rx_phy == RX_2M))
            {
              APP_DBG_MSG("==>> PHY Param  TX= %d, RX= %d \n\r", Tx_phy, Rx_phy);
            }
            else
            {
              APP_DBG_MSG("==>> PHY Param  TX= %d, RX= %d \n\r", Tx_phy, Rx_phy);
            }
          }
          break;

        case HCI_LE_CONNECTION_COMPLETE_SUBEVT_CODE:
        {
          p_connection_complete_event = (hci_le_connection_complete_event_rp0 *) p_meta_evt->data;
          /**
           * The connection is done, there is no need anymore to schedule the LP ADV
           */

          HW_TS_Stop(BleApplicationContext.Advertising_mgr_timer_Id);

          APP_DBG_MSG(">>== HCI_LE_CONNECTION_COMPLETE_SUBEVT_CODE - Connection handle: 0x%x\n", p_connection_complete_event->Connection_Handle);
          APP_DBG_MSG("     - Connection established with Central: @:%02x:%02x:%02x:%02x:%02x:%02x\n",
                      p_connection_complete_event->Peer_Address[5],
                      p_connection_complete_event->Peer_Address[4],
                      p_connection_complete_event->Peer_Address[3],
                      p_connection_complete_event->Peer_Address[2],
                      p_connection_complete_event->Peer_Address[1],
                      p_connection_complete_event->Peer_Address[0]);
          APP_DBG_MSG("     - Connection Interval:   %.2f ms\n     - Connection latency:    %d\n     - Supervision Timeout: %d ms\n\r",
                      p_connection_complete_event->Conn_Interval*1.25,
                      p_connection_complete_event->Conn_Latency,
                      p_connection_complete_event->Supervision_Timeout*10
                     );

          if (BleApplicationContext.Device_Connection_Status == APP_BLE_LP_CONNECTING)
          {
            /* Connection as client */
            BleApplicationContext.Device_Connection_Status = APP_BLE_CONNECTED_CLIENT;
          }
          else
          {
            /* Connection as server */
            BleApplicationContext.Device_Connection_Status = APP_BLE_CONNECTED_SERVER;
          }
          BleApplicationContext.BleApplicationContext_legacy.connectionHandle = p_connection_complete_event->Connection_Handle;
          /**
           * SPECIFIC to P2P Server APP
           */
          HandleNotification.P2P_Evt_Opcode = PEER_CONN_HANDLE_EVT;
          HandleNotification.ConnectionHandle = BleApplicationContext.BleApplicationContext_legacy.connectionHandle;
          P2PS_APP_Notification(&HandleNotification);
          break; /* HCI_LE_CONNECTION_COMPLETE_SUBEVT_CODE */
        }

        default:
          break;
      }

      break; /* HCI_LE_META_EVT_CODE */
    }

    case HCI_VENDOR_SPECIFIC_DEBUG_EVT_CODE:
      p_blecore_evt = (evt_blecore_aci*) p_event_pckt->data;
      switch (p_blecore_evt->ecode)
      {
        /* USER CODE BEGIN ecode */
        aci_gap_pairing_complete_event_rp0 *pairing_complete;

        case ACI_GAP_LIMITED_DISCOVERABLE_VSEVT_CODE: 
          APP_DBG_MSG(">>== ACI_GAP_LIMITED_DISCOVERABLE_VSEVT_CODE \n");
          break; /* ACI_GAP_LIMITED_DISCOVERABLE_VSEVT_CODE */
          
        case ACI_GAP_PASS_KEY_REQ_VSEVT_CODE:  
          APP_DBG_MSG(">>== ACI_GAP_PASS_KEY_REQ_VSEVT_CODE \n");
		  
          ret = aci_gap_pass_key_resp(BleApplicationContext.BleApplicationContext_legacy.connectionHandle,123456);
          if (ret != BLE_STATUS_SUCCESS)
          {
            APP_DBG_MSG("==>> aci_gap_pass_key_resp : Fail, reason: 0x%x\n", ret);
          } 
          else 
          {
            APP_DBG_MSG("==>> aci_gap_pass_key_resp : Success \n");
          }
          break; /* ACI_GAP_PASS_KEY_REQ_VSEVT_CODE */

        case ACI_GAP_AUTHORIZATION_REQ_VSEVT_CODE:    
          APP_DBG_MSG(">>== ACI_GAP_AUTHORIZATION_REQ_VSEVT_CODE\n");
          break; /* ACI_GAP_AUTHORIZATION_REQ_VSEVT_CODE */

        case ACI_GAP_SLAVE_SECURITY_INITIATED_VSEVT_CODE:   
          APP_DBG_MSG("==>> ACI_GAP_SLAVE_SECURITY_INITIATED_VSEVT_CODE \n");
          break; /* ACI_GAP_SLAVE_SECURITY_INITIATED_VSEVT_CODE */

        case ACI_GAP_BOND_LOST_VSEVT_CODE:    
          APP_DBG_MSG("==>> ACI_GAP_BOND_LOST_VSEVT_CODE \n");
          ret = aci_gap_allow_rebond(BleApplicationContext.BleApplicationContext_legacy.connectionHandle);
          if (ret != BLE_STATUS_SUCCESS)
          {
            APP_DBG_MSG("==>> aci_gap_allow_rebond : Fail, reason: 0x%x\n", ret);
          } 
          else 
          {
            APP_DBG_MSG("==>> aci_gap_allow_rebond : Success \n");
          }
          break; /* ACI_GAP_BOND_LOST_VSEVT_CODE */

        case ACI_GAP_ADDR_NOT_RESOLVED_VSEVT_CODE:
          APP_DBG_MSG(">>== ACI_GAP_ADDR_NOT_RESOLVED_VSEVT_CODE \n");
          break; /* ACI_GAP_ADDR_NOT_RESOLVED_VSEVT_CODE */
      
        case (ACI_GAP_KEYPRESS_NOTIFICATION_VSEVT_CODE):
          APP_DBG_MSG(">>== ACI_GAP_KEYPRESS_NOTIFICATION_VSEVT_CODE\n");
          break; /* ACI_GAP_KEYPRESS_NOTIFICATION_VSEVT_CODE */    

        case (ACI_GAP_NUMERIC_COMPARISON_VALUE_VSEVT_CODE):
          APP_DBG_MSG(">>== ACI_GAP_NUMERIC_COMPARISON_VALUE_VSEVT_CODE\n");
          APP_DBG_MSG("     - numeric_value = %ld\n",
                      ((aci_gap_numeric_comparison_value_event_rp0 *)(p_blecore_evt->data))->Numeric_Value);
          APP_DBG_MSG("     - Hex_value = %lx\n",
                      ((aci_gap_numeric_comparison_value_event_rp0 *)(p_blecore_evt->data))->Numeric_Value);
          ret = aci_gap_numeric_comparison_value_confirm_yesno(BleApplicationContext.BleApplicationContext_legacy.connectionHandle, YES); /* CONFIRM_YES = 1 */
          if (ret != BLE_STATUS_SUCCESS)
          {
            APP_DBG_MSG("==>> aci_gap_numeric_comparison_value_confirm_yesno-->YES : Fail, reason: 0x%x\n", ret);
          } 
          else 
          {
            APP_DBG_MSG("==>> aci_gap_numeric_comparison_value_confirm_yesno-->YES : Success \n");
          }
          break;

        case (ACI_GAP_PAIRING_COMPLETE_VSEVT_CODE):
        {
          pairing_complete = (aci_gap_pairing_complete_event_rp0*)p_blecore_evt->data;

          APP_DBG_MSG(">>== ACI_GAP_PAIRING_COMPLETE_VSEVT_CODE\n");
          if (pairing_complete->Status == 0)
          {
            APP_DBG_MSG("     - Pairing Success\n");
          }
          else
          {
            APP_DBG_MSG("     - Pairing KO \n     - Status: 0x%x\n     - Reason: 0x%x\n",pairing_complete->Status, pairing_complete->Reason);
          }
          APP_DBG_MSG("\n");
        }
          break;    
        /* USER CODE END ecode */

        /**
         * SPECIFIC to P2P Server APP
         */
        case ACI_L2CAP_CONNECTION_UPDATE_RESP_VSEVT_CODE:
#if (L2CAP_REQUEST_NEW_CONN_PARAM != 0)
          mutex = 1;
#endif /* L2CAP_REQUEST_NEW_CONN_PARAM != 0 */
          /* USER CODE BEGIN EVT_BLUE_L2CAP_CONNECTION_UPDATE_RESP */

          /* USER CODE END EVT_BLUE_L2CAP_CONNECTION_UPDATE_RESP */
          break;

        case ACI_GAP_PROC_COMPLETE_VSEVT_CODE:
          APP_DBG_MSG(">>== ACI_GAP_PROC_COMPLETE_VSEVT_CODE \r");
          /* USER CODE BEGIN EVT_BLUE_GAP_PROCEDURE_COMPLETE */

          /* USER CODE END EVT_BLUE_GAP_PROCEDURE_COMPLETE */
          break; /* ACI_GAP_PROC_COMPLETE_VSEVT_CODE */

#if (RADIO_ACTIVITY_EVENT != 0)
        case ACI_HAL_END_OF_RADIO_ACTIVITY_VSEVT_CODE:
          /* USER CODE BEGIN RADIO_ACTIVITY_EVENT*/
          BSP_LED_On(LED_GREEN);
          HW_TS_Start(BleApplicationContext.SwitchOffGPIO_timer_Id, (uint32_t)LED_ON_TIMEOUT);
          /* USER CODE END RADIO_ACTIVITY_EVENT*/
          break; /* ACI_HAL_END_OF_RADIO_ACTIVITY_VSEVT_CODE */
#endif /* RADIO_ACTIVITY_EVENT != 0 */

      }
      break; /* HCI_VENDOR_SPECIFIC_DEBUG_EVT_CODE */

    default:
      /* USER CODE BEGIN ECODE_DEFAULT*/

      /* USER CODE END ECODE_DEFAULT*/
      break;
  }

  return (SVCCTL_UserEvtFlowEnable);
}

APP_BLE_ConnStatus_t APP_BLE_Get_Server_Connection_Status(void)
{
  return BleApplicationContext.Device_Connection_Status;
}

/* USER CODE BEGIN FD*/
void APP_BLE_Key_Button1_Action(void)
{
  P2PS_APP_SW1_Button_Action();
}

void APP_BLE_Key_Button2_Action(void)
{
#if (L2CAP_REQUEST_NEW_CONN_PARAM != 0 )    
  UTIL_SEQ_SetTask( 1<<CFG_TASK_CONN_UPDATE_REG_ID, CFG_SCH_PRIO_0);
#endif
  
  return;
}

void APP_BLE_Key_Button3_Action(void)
{
}

/* USER CODE END FD*/

/*************************************************************
 *
 * LOCAL FUNCTIONS
 *
 *************************************************************/
static void Ble_Tl_Init(void)
{
  HCI_TL_HciInitConf_t Hci_Tl_Init_Conf;

  Hci_Tl_Init_Conf.p_cmdbuffer = (uint8_t*)&BleCmdBuffer;
  Hci_Tl_Init_Conf.StatusNotCallBack = BLE_StatusNot;
  hci_init(BLE_UserEvtRx, (void*) &Hci_Tl_Init_Conf);

  return;
}

static void Ble_Hci_Gap_Gatt_Init(void)
{
  uint8_t role;
  uint16_t gap_service_handle, gap_dev_name_char_handle, gap_appearance_char_handle;
  const uint8_t *p_bd_addr;
  uint16_t a_appearance[1] = {BLE_CFG_GAP_APPEARANCE};
  tBleStatus ret = BLE_STATUS_INVALID_PARAMS;
  /* USER CODE BEGIN Ble_Hci_Gap_Gatt_Init*/

  /* USER CODE END Ble_Hci_Gap_Gatt_Init*/

  APP_DBG_MSG("==>> Start Ble_Hci_Gap_Gatt_Init function\n");

  /**
   * Initialize HCI layer
   */
  /*HCI Reset to synchronise BLE Stack*/
  ret = hci_reset();
  if (ret != BLE_STATUS_SUCCESS)
  {
    APP_DBG_MSG("  Fail   : hci_reset command, result: 0x%x \n", ret);
  }
  else
  {
    APP_DBG_MSG("  Success: hci_reset command\n");
  }

  /**
   * Write the BD Address
   */
  p_bd_addr = BleGetBdAddress();
  ret = aci_hal_write_config_data(CONFIG_DATA_PUBADDR_OFFSET, CONFIG_DATA_PUBADDR_LEN, (uint8_t*) p_bd_addr);
  if (ret != BLE_STATUS_SUCCESS)
  {
    APP_DBG_MSG("  Fail   : aci_hal_write_config_data command - CONFIG_DATA_PUBADDR_OFFSET, result: 0x%x \n", ret);
  }
  else
  {
    APP_DBG_MSG("  Success: aci_hal_write_config_data command - CONFIG_DATA_PUBADDR_OFFSET\n");
    APP_DBG_MSG("  Public Bluetooth Address: %02x:%02x:%02x:%02x:%02x:%02x\n",p_bd_addr[5],p_bd_addr[4],p_bd_addr[3],p_bd_addr[2],p_bd_addr[1],p_bd_addr[0]);
  }

#if (CFG_BLE_ADDRESS_TYPE == GAP_PUBLIC_ADDR)
  /* BLE MAC in ADV Packet */
  a_ManufData[ sizeof(a_ManufData)-6] = p_bd_addr[5];
  a_ManufData[ sizeof(a_ManufData)-5] = p_bd_addr[4];
  a_ManufData[ sizeof(a_ManufData)-4] = p_bd_addr[3];
  a_ManufData[ sizeof(a_ManufData)-3] = p_bd_addr[2];
  a_ManufData[ sizeof(a_ManufData)-2] = p_bd_addr[1];
  a_ManufData[ sizeof(a_ManufData)-1] = p_bd_addr[0];
#endif /* CFG_BLE_ADDRESS_TYPE == GAP_PUBLIC_ADDR */

  /**
   * Static random Address
   * The two upper bits shall be set to 1
   * The lowest 32bits is read from the UDN to differentiate between devices
   * The RNG may be used to provide a random number on each power on
   */
#if (CFG_IDENTITY_ADDRESS == GAP_STATIC_RANDOM_ADDR)
#if defined(CFG_STATIC_RANDOM_ADDRESS)
  a_srd_bd_addr[0] = CFG_STATIC_RANDOM_ADDRESS & 0xFFFFFFFF;
  a_srd_bd_addr[1] = (uint32_t)((uint64_t)CFG_STATIC_RANDOM_ADDRESS >> 32);
  a_srd_bd_addr[1] |= 0xC000; /* The two upper bits shall be set to 1 */
#else
  /* Get RNG semaphore */
  while(LL_HSEM_1StepLock(HSEM, CFG_HW_RNG_SEMID));

  /* Enable RNG */
  __HAL_RNG_ENABLE(&hrng);

  if (HAL_RNG_GenerateRandomNumber(&hrng, &a_srd_bd_addr[1]) != HAL_OK)
  {
    /* Random number generation error */
    Error_Handler();
  }
  if (HAL_RNG_GenerateRandomNumber(&hrng, &a_srd_bd_addr[0]) != HAL_OK)
  {
    /* Random number generation error */
    Error_Handler();
  }
  a_srd_bd_addr[1] |= 0xC000; /* The two upper bits shall be set to 1 */

  /* Disable RNG */
  __HAL_RNG_DISABLE(&hrng);

  /* Release RNG semaphore */
  LL_HSEM_ReleaseLock(HSEM, CFG_HW_RNG_SEMID, 0);
#endif /* CFG_STATIC_RANDOM_ADDRESS */
#endif

#if (CFG_BLE_ADDRESS_TYPE != GAP_PUBLIC_ADDR)
  /* BLE MAC in ADV Packet */
  a_ManufData[ sizeof(a_ManufData)-6] = a_srd_bd_addr[1] >> 8 ;
  a_ManufData[ sizeof(a_ManufData)-5] = a_srd_bd_addr[1];
  a_ManufData[ sizeof(a_ManufData)-4] = a_srd_bd_addr[0] >> 24;
  a_ManufData[ sizeof(a_ManufData)-3] = a_srd_bd_addr[0] >> 16;
  a_ManufData[ sizeof(a_ManufData)-2] = a_srd_bd_addr[0] >> 8;
  a_ManufData[ sizeof(a_ManufData)-1] = a_srd_bd_addr[0];

  ret = aci_hal_write_config_data(CONFIG_DATA_RANDOM_ADDRESS_OFFSET, CONFIG_DATA_RANDOM_ADDRESS_LEN, (uint8_t*)a_srd_bd_addr);
  if (ret != BLE_STATUS_SUCCESS)
  {
    APP_DBG_MSG("  Fail   : aci_hal_write_config_data command - CONFIG_DATA_RANDOM_ADDRESS_OFFSET, result: 0x%x \n", ret);
  }
  else
  {
    APP_DBG_MSG("  Success: aci_hal_write_config_data command - CONFIG_DATA_RANDOM_ADDRESS_OFFSET\n");
    APP_DBG_MSG("  Random Bluetooth Address: %02x:%02x:%02x:%02x:%02x:%02x\n", (uint8_t)(a_srd_bd_addr[1] >> 8),
                                                                               (uint8_t)(a_srd_bd_addr[1]),
                                                                               (uint8_t)(a_srd_bd_addr[0] >> 24),
                                                                               (uint8_t)(a_srd_bd_addr[0] >> 16),
                                                                               (uint8_t)(a_srd_bd_addr[0] >> 8),
                                                                               (uint8_t)(a_srd_bd_addr[0]));
  }
#endif /* CFG_BLE_ADDRESS_TYPE != GAP_PUBLIC_ADDR */

  /**
   * Write Identity root key used to derive LTK and CSRK
   */
  ret = aci_hal_write_config_data(CONFIG_DATA_IR_OFFSET, CONFIG_DATA_IR_LEN, (uint8_t*)a_BLE_CfgIrValue);
  if (ret != BLE_STATUS_SUCCESS)
  {
    APP_DBG_MSG("  Fail   : aci_hal_write_config_data command - CONFIG_DATA_IR_OFFSET, result: 0x%x \n", ret);
  }
  else
  {
    APP_DBG_MSG("  Success: aci_hal_write_config_data command - CONFIG_DATA_IR_OFFSET\n");
  }

  /**
   * Write Encryption root key used to derive LTK and CSRK
   */
  ret = aci_hal_write_config_data(CONFIG_DATA_ER_OFFSET, CONFIG_DATA_ER_LEN, (uint8_t*)a_BLE_CfgErValue);
  if (ret != BLE_STATUS_SUCCESS)
  {
    APP_DBG_MSG("  Fail   : aci_hal_write_config_data command - CONFIG_DATA_ER_OFFSET, result: 0x%x \n", ret);
  }
  else
  {
    APP_DBG_MSG("  Success: aci_hal_write_config_data command - CONFIG_DATA_ER_OFFSET\n");
  }

  /**
   * Set TX Power.
   */
  ret = aci_hal_set_tx_power_level(1, CFG_TX_POWER);
  if (ret != BLE_STATUS_SUCCESS)
  {
    APP_DBG_MSG("  Fail   : aci_hal_set_tx_power_level command, result: 0x%x \n", ret);
  }
  else
  {
    APP_DBG_MSG("  Success: aci_hal_set_tx_power_level command\n");
  }

  /**
   * Initialize GATT interface
   */
  ret = aci_gatt_init();
  if (ret != BLE_STATUS_SUCCESS)
  {
    APP_DBG_MSG("  Fail   : aci_gatt_init command, result: 0x%x \n", ret);
  }
  else
  {
    APP_DBG_MSG("  Success: aci_gatt_init command\n");
  }

  /**
   * Initialize GAP interface
   */
  role = 0;

#if (BLE_CFG_PERIPHERAL == 1)
  role |= GAP_PERIPHERAL_ROLE;
#endif /* BLE_CFG_PERIPHERAL == 1 */

#if (BLE_CFG_CENTRAL == 1)
  role |= GAP_CENTRAL_ROLE;
#endif /* BLE_CFG_CENTRAL == 1 */

/* USER CODE BEGIN Role_Mngt*/

/* USER CODE END Role_Mngt */

  if (role > 0)
  {
    const char *name = "P2PSRV1";
    ret = aci_gap_init(role,
                       CFG_PRIVACY,
                       APPBLE_GAP_DEVICE_NAME_LENGTH,
                       &gap_service_handle,
                       &gap_dev_name_char_handle,
                       &gap_appearance_char_handle);

    if (ret != BLE_STATUS_SUCCESS)
    {
      APP_DBG_MSG("  Fail   : aci_gap_init command, result: 0x%x \n", ret);
    }
    else
    {
      APP_DBG_MSG("  Success: aci_gap_init command\n");
    }

    ret = aci_gatt_update_char_value(gap_service_handle, gap_dev_name_char_handle, 0, strlen(name), (uint8_t *) name);
    if (ret != BLE_STATUS_SUCCESS)
    {
      BLE_DBG_SVCCTL_MSG("  Fail   : aci_gatt_update_char_value - Device Name\n");
    }
    else
    {
      BLE_DBG_SVCCTL_MSG("  Success: aci_gatt_update_char_value - Device Name\n");
    }
  }

  ret = aci_gatt_update_char_value(gap_service_handle,
                                   gap_appearance_char_handle,
                                   0,
                                   2,
                                   (uint8_t *)&a_appearance);
  if (ret != BLE_STATUS_SUCCESS)
  {
    BLE_DBG_SVCCTL_MSG("  Fail   : aci_gatt_update_char_value - Appearance\n");
  }
  else
  {
    BLE_DBG_SVCCTL_MSG("  Success: aci_gatt_update_char_value - Appearance\n");
  }

  /**
   * Initialize Default PHY
   */
  ret = hci_le_set_default_phy(ALL_PHYS_PREFERENCE,TX_2M_PREFERRED,RX_2M_PREFERRED);
  if (ret != BLE_STATUS_SUCCESS)
  {
    APP_DBG_MSG("  Fail   : hci_le_set_default_phy command, result: 0x%x \n", ret);
  }
  else
  {
    APP_DBG_MSG("  Success: hci_le_set_default_phy command\n");
  }

  /**
   * Initialize IO capability
   */
  BleApplicationContext.BleApplicationContext_legacy.bleSecurityParam.ioCapability = CFG_IO_CAPABILITY;
  ret = aci_gap_set_io_capability(BleApplicationContext.BleApplicationContext_legacy.bleSecurityParam.ioCapability);
  if (ret != BLE_STATUS_SUCCESS)
  {
    APP_DBG_MSG("  Fail   : aci_gap_set_io_capability command, result: 0x%x \n", ret);
  }
  else
  {
    APP_DBG_MSG("  Success: aci_gap_set_io_capability command\n");
  }

  /**
   * Initialize authentication
   */
  BleApplicationContext.BleApplicationContext_legacy.bleSecurityParam.mitm_mode = CFG_MITM_PROTECTION;
  BleApplicationContext.BleApplicationContext_legacy.bleSecurityParam.encryptionKeySizeMin = CFG_ENCRYPTION_KEY_SIZE_MIN;
  BleApplicationContext.BleApplicationContext_legacy.bleSecurityParam.encryptionKeySizeMax = CFG_ENCRYPTION_KEY_SIZE_MAX;
  BleApplicationContext.BleApplicationContext_legacy.bleSecurityParam.Use_Fixed_Pin = CFG_USED_FIXED_PIN;
  BleApplicationContext.BleApplicationContext_legacy.bleSecurityParam.Fixed_Pin = CFG_FIXED_PIN;
  BleApplicationContext.BleApplicationContext_legacy.bleSecurityParam.bonding_mode = CFG_BONDING_MODE;
  /* USER CODE BEGIN Ble_Hci_Gap_Gatt_Init_1*/

  /* USER CODE END Ble_Hci_Gap_Gatt_Init_1*/

  ret = aci_gap_set_authentication_requirement(BleApplicationContext.BleApplicationContext_legacy.bleSecurityParam.bonding_mode,
                                               BleApplicationContext.BleApplicationContext_legacy.bleSecurityParam.mitm_mode,
                                               CFG_SC_SUPPORT,
                                               CFG_KEYPRESS_NOTIFICATION_SUPPORT,
                                               BleApplicationContext.BleApplicationContext_legacy.bleSecurityParam.encryptionKeySizeMin,
                                               BleApplicationContext.BleApplicationContext_legacy.bleSecurityParam.encryptionKeySizeMax,
                                               BleApplicationContext.BleApplicationContext_legacy.bleSecurityParam.Use_Fixed_Pin,
                                               BleApplicationContext.BleApplicationContext_legacy.bleSecurityParam.Fixed_Pin,
                                               CFG_IDENTITY_ADDRESS);
  if (ret != BLE_STATUS_SUCCESS)
  {
    APP_DBG_MSG("  Fail   : aci_gap_set_authentication_requirement command, result: 0x%x \n", ret);
  }
  else
  {
    APP_DBG_MSG("  Success: aci_gap_set_authentication_requirement command\n");
  }

  /**
   * Initialize whitelist
   */
  if (BleApplicationContext.BleApplicationContext_legacy.bleSecurityParam.bonding_mode)
  {
    ret = aci_gap_configure_whitelist();
    if (ret != BLE_STATUS_SUCCESS)
    {
      APP_DBG_MSG("  Fail   : aci_gap_configure_whitelist command, result: 0x%x \n", ret);
    }
    else
    {
      APP_DBG_MSG("  Success: aci_gap_configure_whitelist command\n");
    }
  }
  APP_DBG_MSG("==>> End Ble_Hci_Gap_Gatt_Init function\n\r");
}

static void Adv_Request(APP_BLE_ConnStatus_t NewStatus)
{
  tBleStatus ret = BLE_STATUS_INVALID_PARAMS;
  uint16_t Min_Inter, Max_Inter;

  if (NewStatus == APP_BLE_FAST_ADV)
  {
    Min_Inter = AdvIntervalMin;
    Max_Inter = AdvIntervalMax;
  }
  else
  {
    Min_Inter = CFG_LP_CONN_ADV_INTERVAL_MIN;
    Max_Inter = CFG_LP_CONN_ADV_INTERVAL_MAX;
  }

  /**
   * Stop the timer, it will be restarted for a new shot
   * It does not hurt if the timer was not running
   */
  HW_TS_Stop(BleApplicationContext.Advertising_mgr_timer_Id);

  if ((NewStatus == APP_BLE_LP_ADV)
      && ((BleApplicationContext.Device_Connection_Status == APP_BLE_FAST_ADV)
          || (BleApplicationContext.Device_Connection_Status == APP_BLE_LP_ADV)))
  {
    /* Connection in ADVERTISE mode have to stop the current advertising */
    ret = aci_gap_set_non_discoverable();
    if (ret != BLE_STATUS_SUCCESS)
    {
      APP_DBG_MSG("==>> aci_gap_set_non_discoverable - Stop Advertising Failed , result: %d \n", ret);
    }
    else
    {
      APP_DBG_MSG("==>> aci_gap_set_non_discoverable - Successfully Stopped Advertising \n");
    }
  }

  BleApplicationContext.Device_Connection_Status = NewStatus;
  /* Start Fast or Low Power Advertising */
  ret = aci_gap_set_discoverable(ADV_IND,
                                 Min_Inter,
                                 Max_Inter,
                                 CFG_BLE_ADDRESS_TYPE,
                                 NO_WHITE_LIST_USE, /* use white list */
                                 sizeof(a_LocalName),
                                 (uint8_t*) &a_LocalName,
                                 BleApplicationContext.BleApplicationContext_legacy.advtServUUIDlen,
                                 BleApplicationContext.BleApplicationContext_legacy.advtServUUID,
                                 0,
                                 0);
  if (ret != BLE_STATUS_SUCCESS)
  {
    APP_DBG_MSG("==>> aci_gap_set_discoverable - fail, result: 0x%x \n", ret);
  }
  else
  {
    APP_DBG_MSG("==>> aci_gap_set_discoverable - Success\n");
  }

  /* Update Advertising data */
  ret = aci_gap_update_adv_data(sizeof(a_ManufData), (uint8_t*) a_ManufData);
  if (ret != BLE_STATUS_SUCCESS)
  {
    if (NewStatus == APP_BLE_FAST_ADV)
    {
      APP_DBG_MSG("==>> Start Fast Advertising Failed , result: %d \n\r", ret);
    }
    else
    {
      APP_DBG_MSG("==>> Start Low Power Advertising Failed , result: %d \n\r", ret);
    }
  }
  else
  {
    if (NewStatus == APP_BLE_FAST_ADV)
    {
      APP_DBG_MSG("==>> Success: Start Fast Advertising \n\r");
      /* Start Timer to STOP ADV - TIMEOUT - and next Restart Low Power Advertising */
      HW_TS_Start(BleApplicationContext.Advertising_mgr_timer_Id, INITIAL_ADV_TIMEOUT);
    }
    else
    {
      APP_DBG_MSG("==>> Success: Start Low Power Advertising \n\r");
    }
  }

  return;
}

const uint8_t* BleGetBdAddress(void)
{
  uint8_t *p_otp_addr;
  const uint8_t *p_bd_addr;
  uint32_t udn;
  uint32_t company_id;
  uint32_t device_id;

  udn = LL_FLASH_GetUDN();

  if (udn != 0xFFFFFFFF)
  {
    company_id = LL_FLASH_GetSTCompanyID();
    device_id = LL_FLASH_GetDeviceID();

    /**
     * Public Address with the ST company ID
     * bit[47:24] : 24bits (OUI) equal to the company ID
     * bit[23:16] : Device ID.
     * bit[15:0] : The last 16bits from the UDN
     * Note: In order to use the Public Address in a final product, a dedicated
     * 24bits company ID (OUI) shall be bought.
     */
    a_BdAddrUdn[0] = (uint8_t)(udn & 0x000000FF);
    a_BdAddrUdn[1] = (uint8_t)((udn & 0x0000FF00) >> 8);
    a_BdAddrUdn[2] = (uint8_t)device_id;
    a_BdAddrUdn[3] = (uint8_t)(company_id & 0x000000FF);
    a_BdAddrUdn[4] = (uint8_t)((company_id & 0x0000FF00) >> 8);
    a_BdAddrUdn[5] = (uint8_t)((company_id & 0x00FF0000) >> 16);

    p_bd_addr = (const uint8_t *)a_BdAddrUdn;
  }
  else
  {
    p_otp_addr = OTP_Read(0);
    if (p_otp_addr)
    {
      p_bd_addr = ((OTP_ID0_t*)p_otp_addr)->bd_address;
    }
    else
    {
      p_bd_addr = a_MBdAddr;
    }
  }

  return p_bd_addr;
}

/*************************************************************
 *
 * SPECIFIC FUNCTIONS FOR P2P SERVER
 *
 *************************************************************/
static void Adv_Cancel(void)
{
  /* USER CODE BEGIN Adv_Cancel_1 */
  BSP_LED_Off(LED_GREEN);
  /* USER CODE END Adv_Cancel_1 */

  if (BleApplicationContext.Device_Connection_Status != APP_BLE_CONNECTED_SERVER)
  {
    tBleStatus ret = BLE_STATUS_INVALID_PARAMS;

    ret = aci_gap_set_non_discoverable();

    BleApplicationContext.Device_Connection_Status = APP_BLE_IDLE;
    if (ret != BLE_STATUS_SUCCESS)
    {
      APP_DBG_MSG("** STOP ADVERTISING **  Failed \r\n\r");
    }
    else
    {
      APP_DBG_MSG("  \r\n\r");
      APP_DBG_MSG("** STOP ADVERTISING **  \r\n\r");
    }
  }

  return;
}

static void Adv_Cancel_Req(void)
{
  UTIL_SEQ_SetTask(1 << CFG_TASK_ADV_CANCEL_ID, CFG_SCH_PRIO_0);

  return;
}

static void Switch_OFF_GPIO()
{
  /* USER CODE BEGIN Switch_OFF_GPIO */
  BSP_LED_Off(LED_GREEN);
  /* USER CODE END Switch_OFF_GPIO */
}

#if (L2CAP_REQUEST_NEW_CONN_PARAM != 0)
void BLE_SVC_L2CAP_Conn_Update(uint16_t ConnectionHandle)
{
  if (mutex == 1)
  {
    mutex = 0;
    index_con_int = (index_con_int + 1)%SIZE_TAB_CONN_INT;
    uint16_t interval_min = CONN_P(a_ConnInterval[index_con_int]);
    uint16_t interval_max = CONN_P(a_ConnInterval[index_con_int]);
    uint16_t slave_latency = L2CAP_SLAVE_LATENCY;
    uint16_t timeout_multiplier = L2CAP_TIMEOUT_MULTIPLIER;
    tBleStatus ret;

    ret = aci_l2cap_connection_parameter_update_req(BleApplicationContext.BleApplicationContext_legacy.connectionHandle,
                                                    interval_min, interval_max,
                                                    slave_latency, timeout_multiplier);
    if (ret != BLE_STATUS_SUCCESS)
    {
      APP_DBG_MSG("BLE_SVC_L2CAP_Conn_Update(), Failed \r\n\r");
    }
    else
    {
      APP_DBG_MSG("BLE_SVC_L2CAP_Conn_Update(), Successfully \r\n\r");
    }
  }

  return;
}
#endif /* L2CAP_REQUEST_NEW_CONN_PARAM != 0 */

#if (L2CAP_REQUEST_NEW_CONN_PARAM != 0)
static void Connection_Interval_Update_Req(void)
{
  if (BleApplicationContext.Device_Connection_Status != APP_BLE_FAST_ADV && BleApplicationContext.Device_Connection_Status != APP_BLE_IDLE)
  {
    BLE_SVC_L2CAP_Conn_Update(BleApplicationContext.BleApplicationContext_legacy.connectionHandle);
  }

  return;
}
#endif /* L2CAP_REQUEST_NEW_CONN_PARAM != 0 */

/*************************************************************
 *
 * WRAP FUNCTIONS
 *
 *************************************************************/
void hci_notify_asynch_evt(void* p_Data)
{
  UTIL_SEQ_SetTask(1 << CFG_TASK_HCI_ASYNCH_EVT_ID, CFG_SCH_PRIO_0);

  return;
}

void hci_cmd_resp_release(uint32_t Flag)
{
  UTIL_SEQ_SetEvt(1 << CFG_IDLEEVT_HCI_CMD_EVT_RSP_ID);

  return;
}

void hci_cmd_resp_wait(uint32_t Timeout)
{
  UTIL_SEQ_WaitEvt(1 << CFG_IDLEEVT_HCI_CMD_EVT_RSP_ID);

  return;
}

static void BLE_UserEvtRx(void *p_Payload)
{
  SVCCTL_UserEvtFlowStatus_t svctl_return_status;
  tHCI_UserEvtRxParam *p_param;

  p_param = (tHCI_UserEvtRxParam *)p_Payload;

  svctl_return_status = SVCCTL_UserEvtRx((void *)&(p_param->pckt->evtserial));
  if (svctl_return_status != SVCCTL_UserEvtFlowDisable)
  {
    p_param->status = HCI_TL_UserEventFlow_Enable;
  }
  else
  {
    p_param->status = HCI_TL_UserEventFlow_Disable;
  }

  return;
}

static void BLE_StatusNot(HCI_TL_CmdStatus_t Status)
{
  uint32_t task_id_list;
  switch (Status)
  {
    case HCI_TL_CmdBusy:
      /**
       * All tasks that may send an aci/hci commands shall be listed here
       * This is to prevent a new command is sent while one is already pending
       */
      task_id_list = (1 << CFG_LAST_TASK_ID_WITH_HCICMD) - 1;
      UTIL_SEQ_PauseTask(task_id_list);
      break;

    case HCI_TL_CmdAvailable:
      /**
       * All tasks that may send an aci/hci commands shall be listed here
       * This is to prevent a new command is sent while one is already pending
       */
      task_id_list = (1 << CFG_LAST_TASK_ID_WITH_HCICMD) - 1;
      UTIL_SEQ_ResumeTask(task_id_list);
      break;

    default:
      break;
  }

  return;
}

void SVCCTL_ResumeUserEventFlow(void)
{
  hci_resume_flow();

  return;
}
