midhunjac/RF-handover/(commit log)

2024-02-27 All the PCBs and code
    [BLE_Beacon_Temperature Debug.cfg, BLE_p2pClient Debug.cfg, BLE_v1.xlsx, BOM.xlsx, BOM_components.xlsx, BodyPos_v1.xlsx, Cadence_Power Supply_v1.xlsx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]
2024-02-27 Adding UI for a receiver
    [test.xlsx]
2024-02-27 Adding Getting started with STM32 section
2024-02-27 Reverting to single temperature sensor
    [ibeacon_service.c]
