midhunjac/RF-handover/(notices)

Notices in the files:
rtc_ble_test/Core/Inc/hw_conf.h:
Copyright (c) 2023 STMicroelectronics.
All rights reserved.
RF-Wireless-Sensors-main/STM32Cube_FW_WB_V1.17.0/Projects/NUCLEO-WB15CC/Applications/BLE/BLE_p2pClient/STM32_WPAN/App/app_ble.c:
Copyright (c) 2021 STMicroelectronics.
parts and their libraries:
Copyright 2021 Accelerated Designs. All rights reserved.
